JQIamo/Linear-Temperature-Controller/v1_0 (first prod run)/LinTempCont_v1_0_BOM.xlsx

 |  |  |  |  |  |  |  |  |  |  |  |  | Needed | Packed | Extra
Item # | Qty | Value | Ref Des | Device | Package | Description | DIGIKEY | MFR_PN | Type | SMT | Thru Hole | Comments
1 | 4 |  | D1, D2, D3, D4 | LED/MINI-IND | HLMP--F0010 | Through-hole, side-view LED | 516-1417-ND |  | thru-hole |  | 4 | y | 44 | 46 | 2
2 | 9 |  | JP3, JP5, JP6, JP7, JP9, JP10, JP12, JP13, JP14 | PINHD-1X2 | 1X02 | PIN HEADER | 952-2262-ND |  | thru-hole |  | 9 | y | 99 | 100 | 1
3 | 1 |  | LCD_HEADER | PINHD-2X4-SHROUD | ML08 | PIN HEADER | 609-3530-ND |  | thru-hole |  | 1 | y | 11 | 11 | 0 | have lots more
4 | 4 |  | JP1, JP2, JP8, JP11 | PINHD-2X6/90 | 2X06/90 | PIN HEADER | 609-3345-ND |  | thru-hole |  | 4 | y | 44 | 46 | 2
5 | 1 |  | JP4 | SCRWTRM-1X2 | 1X02_SCRWTRM | Screw Terminal | ED2635-ND | OSTTE020161 | thru-hole |  | 1 | y | 11 | 12 | 1
6 | 4 |  | S1, S2, S3, S4 | SWITCH-DPDT/VER | E-SWITCH-100-M7 | DPDT Switch | 100DP1T2B4M7QE-ND | 100DP1T2B4M7QE | thru-hole |  | 4 | y | 44 | 46 | 2
7 | 1 |  | IC6 | TS6001 | SOT-23 | 2.5V Reference IC | TS6001BIG325TCT-ND |  | smt | 1 |  | x | 11 | 11 | 0
8 | 15 | 0.1uF | C1, C3, C4, C5, C6, C7, C8, C9, C11, C12, C15, C20, C22, C24, C27 | CAP0603 | 0603 | SMT Capacitor | 399-5089-1-ND |  | smt | 15 |  | x | 165 | 185 | 20
9 | 12 | 1.0k | R14, R15, R18, R52, R53, R54, R70, R71, R72, R88, R89, R90 | RES0603 | 0603 | SMT Resistor | MCT0603-1.00K-CFCT-ND |  | smt | 12 |  | x | 132 | 138 | 6
10 | 8 | 1.5k | R2, R4, R38, R40, R56, R58, R74, R76 | RES0603 | 0603 | SMT Resistor | MCT0603-1.50K-CFCT-ND |  | smt | 8 |  | x | 88 | 92 | 4
11 | 2 | 1000pF | C10, C14 | CAP0603 | 0603 | SMT Capacitor | 399-3293-1-ND |  | smt | 2 |  | x | 22 | 49 | 27
12 | 8 | 10k | R6, R7, R41, R42, R59, R60, R77, R78 | MODEL64_TRIMPOT/TOP-ADJ | 64WPOT | Trimpot | 987-1061-ND |  | thru-hole |  | 8 | y | 88 | 92 | 4
13 | 34 | 10k | R8, R9, R10, R12, R13, R19, R20, R21, R22, R23, R24, R25, R26, R27, R28, R29, R32, R33, R34, R43, R44, R45, R47, R48, R61, R62, R63, R65, R66, R79, R80, R81, R83, R84 | RES0603 | 0603 | SMT Resistor | MCT0603-10.0K-CFCT-ND |  | smt | 34 |  | x | 374 | 466 | 92
14 | 4 | 10nF | C16, C17, C18, C19 | C-EUC0603 | C0603 | SMT Capacitor | 399-1091-1-ND |  | smt | 4 |  | x | 44 | 50 | 6
15 | 7 | 10uF | CP2, C2, C13, C21, C23, C25, C30 | CAP0805 | 0805 | SMT Capacitor | 1276-2891-1-ND |  | smt | 7 |  | x | 77 | 100 | 23
16 | 1 | 220uF | CP1 | CPOL-USF | PANASONIC_F | SMT Polarized Capacitor | PCE3955CT-ND |  | smt | 1 |  | x | 11 | 12 | 1
17 | 4 | 330 | R5, R49, R67, R85 | RES0603 | 0603 | SMT Resistor | MCT0603-330-CFCT-ND |  | smt | 4 |  | x | 44 | 46 | 2
18 | 4 | 33k | R11, R46, R64, R82 | RES0603 | 0603 | SMT Resistor | MCT0603-33.0K-CFCT-ND |  | smt | 4 |  | x | 44 | 46 | 2
19 | 8 | 4.3k | R1, R3, R37, R39, R55, R57, R73, R75 | RES0603 | 0603 | SMT Resistor | 541-4.3KGCT-ND |  | smt | 8 |  | x | 88 | 92 | 4
20 | 1 | 47uF | CP3 | CPOL-USCT7343 | CT7343 | SMT Polarized Capacitor | 495-1571-1-ND |  | smt | 1 |  | x | 11 | 12 | 1
21 | 4 | 50 | R30, R31, R35, R36 | RES0603 | 0603 | SMT Resistor | 541-51GCT-ND |  | smt | 4 |  | x | 44 | 46 | 2
22 | 4 | AD5262 | IC4, IC5, IC8, IC10 | AD5262 | TSSOP16 | AD5262 dual circuit digital pot | AD5262BRUZ200-ND |  | smt | 4 |  | x | 44 | 45 | 1
23 | 1 | AD5624R | IC3 | AD5624R | MSOP10 | AD5624R Quad Output DAC w/internal Vref | AD5624RBRMZ-3-ND |  | smt | 1 |  | x | 11 | 12 | 1
24 | 8 | BNC-H | X1, X2, X3, X4, X5, X6, X7, X8 | BNC-H | BNC90 | BNC Connector. | A32260-ND |  | thru-hole |  | 8 |  | 88 | 28 | -60
25 | 4 | Ferrite 1k | L1, L2, L3, L4 | INDUCTOR-0805 | 0805 | SMT Inductor. | 445-5223-1-ND |  | smt | 4 |  | x | 44 | 49 | 5
26 | 4 | LM393D | IC1, IC2, IC7, IC9 | LM393D | SO08 | COMPARATOR | 296-1015-5-ND |  | smt | 4 |  | x | 44 | 47 | 3
27 | 8 | MMBT3904 | T1, T2, T3, T4, T5, T6, T7, T8 | MMBT3904 | SOT-23 | NPN TRANSISTOR | MMBT3904-FDICT-ND |  | smt | 8 |  | x | 88 | 94 | 6
28 | 2 | PEC09 | ENC1, ENC2 | PEC09 | PEC092320FS | PEC09-2320F-S0015 Rotary Encoder (Bourns). | PEC09-2320F-S0015-ND |  | thru-hole |  | 2 | y | 22 | 25 | 3
29 | 1 | TEENSY_3.1+4 | U$1 | TEENSY_3.1+4 | TEENSY_3.1+4 | Footprint for Teensy 3.1 board using all through-holes |  |  | DNP |  |  | **DO NOT PLACE | 11
30 | 27 | TESTPT | TP1, TP2, TP3, TP4, TP5, TP6, TP7, TP8, TP9, TP10, TP11, TP12, TP13, TP14, TP15, TP16, TP17, TP18, TP19, TP20, TP21, TP22, TP23, TP24, TP25, TP26, TP27 | TESTPT | 1206TESTPAD |  | A106143CT-ND |  | smt | 27 |  | x | 297 | 303 | 6
 |  |  |  |  |  |  |  |  |  | 153 | 41
