JQIamo/Linear-Temperature-Controller/v1_0 (first prod run)/Digikey Order.xlsx

web id: | 148701440 |  |  |  |  |  |  | **means a part is for the individual channel temp controller circuit
access id: | 38776
item number | part number | description | customer reference | qty | unit price | ext price
1 | 609-3345-ND | CONN HEADER 12POS .100 R/A 15AU | JP1, JP2, JP8, JP11 | 50 | 0.8056 | $40.28
2 | MMBT3904-FDICT-ND | TRANS NPN 40V 0.2A SMD SOT23-3 | T1, T2, T3, T4, T5, T6, T7, T8 | 100 | 0.0742 | $7.42
3 | 296-1015-5-ND | IC DUAL DIFF COMP 8-SOIC | IC1, IC2, IC7, IC9 | 50 | 0.3 | $15.00
4 | AD5262BRUZ200-ND | IC POT DUAL 200K 256POS 16TSSOP | IC4, IC5, IC8, IC10 | 48 | 4.679 | $224.59
5 | AD5624RBRMZ-3-ND | IC DAC NANO 12BIT 1.25V 10-MSOP | IC3 | 12 | 9.79 | $117.48
6 | A32260-ND | CONN BNC JACK R/A 50 OHM PCB | X1-X8 | 45 | 2.74 | $123.30
7 | TS6001BIG325TCT-ND | IC VREF SERIES 2.5V SOT23-3 | IC6 | 12 | 0.871 | $10.45
8 | 445-5223-1-ND | FERRITE CHIP 1000 OHM 1.5A 0805 | L1, L2, L3, L4 | 100 | 0.0574 | $5.74
9 | A106143CT-ND | 1206 PROBE PAD | TP1-27 | 330 | 0.152 | $50.16
10 | PCE3955CT-ND | CAP ALUM 220UF 20% 35V SMD | CP1 | 75 | 0.4872 | $36.54
11 | 516-1417-ND | LED DOME 565NM GRN DIFF RA AXIAL | D1-D4 | 50 | 0.4436 | $22.18
12 | 987-1061-ND | TRIMMER 10K OHM 0.25W TH | R6, R7, R41, R42, R59, R60, R77, R78 | 100 | 1.176 | $117.60
13 | PEC09-2320F-S0015-ND | ENCODER INCREMENTAL 9MM W/SWITCH | ENC1, ENC2 | 25 | 2.8692 | $71.73
14 | 450-1693-ND | SWITCH KNOB DIAMOND .50" BLACK |  | 25 | 4.57 | $114.25
15 | ED2635-ND | TERM BLOCK 3.5MM VERT 2POS PCB | JP4 | 12 | 0.402 | $4.82
16 | 100DP1T2B4M7QE-ND | SWITCH TOGGLE DPDT 5A 120V | S1-S4 | 50 | 3.3768 | $168.84
17 | 609-3530-ND | CONN HEADER 8POS DUAL VERT PCB |  | 50 | 0.5972 | $29.86
18 | 399-1091-1-ND | CAP CER 10000PF 50V 10% X7R 0603 | C1, C16, C17, C18, C19 | 250 | 0.00736 | $1.84
19 | 1276-2891-1-ND | CAP CER 10UF 25V 10% X5R 0805 | CP2, C2, C13, C21, C23, C25, C30 | 250 | 0.1024 | $25.60
20 | 399-3293-1-ND | CAP CER 1000PF 50V 5% NP0 0603 | C14 | 50 | 0.0318 | $1.59
21 | 399-5089-1-ND | CAP CER 0.1UF 50V 10% X7R 0603 | C3-C12, C15, C20, C22, C24, C27 | 250 | 0.01532 | $3.83
22 | 952-2262-ND | SIL VERTICAL PC TAIL PIN HEADER | JP3, JP5-JP7, JP9, JP10, JP12-JP14 | 100 | 0.0609 | $6.09
23 | MCT0603-10.0K-CFCT-ND | RES SMD 10K OHM 1% 1/8W 0603 | RR1 - RR34 | 500 | 0.033 | $16.50
24 | MCT0603-1.00K-CFCT-ND | RES SMD 1K OHM 1% 1/8W 0603 | R14, R15, R18, R52-R54, R70-R72, R88-R90 | 150 | 0.0408 | $6.12
25 | MCT0603-1.50K-CFCT-ND | RES SMD 1.5K OHM 1% 1/8W 0603 | R2, R4, R38, R40, R56, R58, R74, R76 | 100 | 0.0408 | $4.08
26 | MCT0603-330-CFCT-ND | RES SMD 330 OHM 1% 1/8W 0603 | R5, R49, R67, R85 | 50 | 0.0516 | $2.58
27 | MCT0603-33.0K-CFCT-ND | RES SMD 33K OHM 1% 1/8W 0603 | R11, R46, R64, R82 | 50 | 0.0516 | $2.58
28 | 541-4.3KGCT-ND | RES SMD 4.3K OHM 5% 1/10W 0603 | R1, R3, R37, R39, R55, R57, R73, R75 | 100 | 0.04 | $4.00
29 | 541-51GCT-ND | RES SMD 51 OHM 5% 1/10W 0603 | R30, R31, R35, R36 | 50 | 0.04 | $2.00
30 | S7109-ND | CONN HEADER FMAL 12PS.1" DL GOLD | **JP3 | 50 | 0.7042 | $35.21
31 | OP727ARUZ-ND | IC OPAMP GP 700KHZ RRO 8TSSOP | **IC1 | 50 | 4.133 | $206.65
32 | 296-18688-1-ND | IC OPAMP DIFF 1.5MHZ 8VSSOP | **IC2 | 50 | 3.58 | $179.00
33 | ED1501-ND | TERMINAL BLOCK 3.5MM 2POS PCB | **JP2 | 50 | 0.5064 | $25.32
34 | ED1503-ND | TERMINAL BLOCK 3.5MM 4POS PCB | **JP1 | 50 | 0.9706 | $48.53
35 | 541-0.0GCT-ND | RES SMD 0.0 OHM JUMPER 1/10W | **R1, R2 | 100 | 0.04 | $4.00
36 | MCT0603-100K-CFCT-ND | RES SMD 100K OHM 1% 1/8W 0603 | **R4, R5 | 100 | 0.0408 | $4.08
37 | 1276-2876-1-ND | CAP CER 10UF 50V 10% X5R 1206 | **CP2 | 50 | 0.4424 | $22.12
38 | A119984CT-ND | RES SMD 20K OHM 0.1% 1/10W 0805 | **R6 | 50 | 0.33 | $16.50
39 | 495-1571-1-ND | CAP TANT 47UF 25V 10% 2917 | CP3 | 75 | 1.264 | $94.80
40 | 311-1900-1-ND | CAP CER 22UF 10V 20% X5R 0805 | **C1 | 50 | 0.1612 | $8.06
41 | MCT0603-3.30K-CFCT-ND | RES SMD 3.3K OHM 1% 1/8W 0603 | **R3 | 50 | 0.0516 | $2.58
42 | 587-1757-1-ND | FERRITE BEAD 1000 OHM 1810 | **LP2 | 50 | 0.3342 | $16.71
43 | CDPM1000-ND | AC/DC CONVERTER 5V 1W |  | 10 | 19.855 | $198.55
44 | A208-ND | CONN SOCKET SIP 25POS GOLD |  | 40 | 3.2176 | $128.70
45 | 931-1188-ND | HIROSE U.FL TO SMA(F) 200MM |  | 15 | 6.49 | $97.35 | for long steck lasers
46 | 102-2527-ND | AC/DC CONVERTER 5V 12V 30W |  | 3 | 28.48 | $85.44
47 | 454-1423-ND | AC/DC CONVERTER 24V 60W |  | 1 | 24.41 | $24.41
48 | 454-1597-ND | KIT CONNECTOR MATING LPX25/40/60 |  | 1 | 9.68 | $9.68
49 | 259-1551-ND | FAN AXIAL 30X10MM VAPO 5VDC WIRE |  | 10 | 6.088 | $60.88
50 | 259-1549-ND | FAN AXIAL 30X10MM 12VDC WIRE |  | 10 | 6.799 | $67.99
51 | MD08R-100-ND | CBL RIBN 8COND 0.050 GRAY 100' |  | 1 | 42.35 | $42.35 | for lcd breakout boards
52 | 609-3568-ND | CONN SOCKET IDC 8POS DL SR 30AU |  | 100 | 0.7106 | $71.06 | for lcd breakout boards
53 | WM17458-ND | CONN HEADER 8POS .100" VERT 15AU |  | 50 | 0.5882 | $29.41 | for lcd breakout boards
54 | NHD-C0216CZ-FSW-FBW-3V3-ND | LCD COG CHAR 2X16 WHT TRANSFL |  | 10 | 9.68 | $96.80 | for lcd breakout boards
55 | AD8038AKSZ-REEL7CT-ND | IC OPAMP VFB 350MHZ SC70-5 | AOM_OP_AMP | 10 | 2.052 | $20.52 | for aom board
56 | LMH6629MFE/NOPBCT-ND | IC OPAMP VFB 1GHZ SOT23-5 | PD_AMP | 5 | 5.16 | $25.80 | for photodiode amplifier board
57 | 296-15172-1-ND | IC OPAMP VFB 3.9GHZ SOT23-6 | PD_AMP_2 | 2 | 6.54 | $13.08 | for photodiode amplifier board
 |  |  |  |  |  | $2872.63
