JQIamo/Linear-Temperature-Controller/v1_0 (first prod run)/indCh_v0_9/LinTempCont_indCH_v1_0_BOM.xlsx

Sheet: Sheet1
Item # | Qty | Ref Des | Value | Device | Package | Description | DIGIKEY PN | Type | Comments
1 | 1 | IC2 |  | INA159 | VSSOP8 | INA159 Difference Amplifier, Texas Instruments | 296-18688-1-ND | smt
2 | 1 | IC1 |  | OP727 | TSSOP8 | OP727 Dual Op Amp | OP727ARUZ-ND | smt
3 | 1 | JP3 |  | PINHD-2X6 | 2X06 | PIN HEADER |  | DNP | **DO NOT PLACE
4 | 1 | JP2 |  | SCRWTRM-1X2/90_ED550 | 1X02_RA_SCRWTRM_ED550 | Screw Terminal | ED1501-ND | DNP | **DO NOT PLACE
5 | 1 | JP1 |  | SCRWTRM-1X4/90_ED550 | 1X04_RA_SCRWTRM_ED550 | Screw Terminal | ED1503-ND | thru-hole
6 | 1 | U1 |  | WTC3243 | WTC3293 | WTC3243 linear temp controller chip from Team Wavelength |  | DNP | **DO NOT PLACE
7 | 2 | R1, R2 | 0 | RES0603 | 0603 | SMT Resistor | 541-0.0GCT-ND | smt
8 | 1 | C8 | 0.1uF | CAP0603 | 0603 | SMT Capacitor | 399-5089-1-ND | smt
9 | 2 | R4, R5 | 100k 1% | RES0603 | 0603 | SMT Resistor | MCT0603-100K-CFCT-ND | smt
10 | 3 | C2, C5, C6 | 10nF | CAP0603 | 0603 | SMT Capacitor | 399-1091-1-ND | smt
11 | 3 | C3, C4, C7 | 10uF | CAP0805 | 0805 | SMT Capacitor | 1276-2891-1-ND | smt
12 | 1 | CP2 | 10uF 50V | C-USC1206 | C1206 | SMT Capacitor | 1276-2876-1-ND | smt
13 | 1 | R6 | 20k 0.1% | R_SMDR0805 | R_0805 | SMT Resistor | A119984CT-ND | smt
14 | 1 | CP1 | 220uF | CPOL-USF | PANASONIC_F | SMT Polarized Capacitor | PCE3955CT-ND | smt
15 | 1 | C1 | 22uF | CAP0805 | 0805 | SMT Capacitor | 311-1900-1-ND | smt
16 | 1 | R3 | 3.3k | RES0603 | 0603 | SMT Resistor | MCT0603-3.30K-CFCT-ND | smt
17 | 1 | CP3 | 47uF | CPOL-USCT7343 | CT7343 | SMT Polarized Capacitor | 495-1571-1-ND | smt
18 | 1 | LP2 | Ferrite 1k | L_FERRITE_SMD | L_FERRITE_1810 | SMT Inductor | 587-1757-1-ND | smt
19 | 3 | RI, RP, RSG |  | RES0603 | 0603 | SMT Resistor |  | DNP | **DO NOT PLACE
20 | 1 | L1 | Ferrite 1k | INDUCTOR-0805 | 0805 | SMT Inductor | 445-5223-1-ND | smt

Sheet: Sheet2
Qty | Device | Package | Description | DIGIKEY | MFR_PN
1 | INA159 | VSSOP8 | INA159 Difference Amplifier, Texas Instruments | 296-18688-1-ND
1 | OP727 | TSSOP8 | OP727 Dual Op Amp | OP727ARUZ-ND
1 | PINHD-2X6 | 2X06 | PIN HEADER
1 | SCRWTRM-1X2/90_ED550 | 1X02_RA_SCRWTRM_ED550 | Screw Terminal | ED1501-ND | ED550/2DS
1 | SCRWTRM-1X4/90_ED550 | 1X04_RA_SCRWTRM_ED550 | Screw Terminal | ED1503-ND | ED550/4DS
1 | WTC3243 | WTC3293 | WTC3243 linear temp controller chip from Team Wavelength
2 | RES0603 | 603 | SMT Resistor
1 | CAP0603 | 603 | SMT Capacitor
2 | RES0603 | 603 | SMT Resistor
1 | C-USC0603 | C0603 | CAPACITOR, American symbol
2 | CAP0603 | 603 | SMT Capacitor
1 | C-USC0805 | C0805 | CAPACITOR, American symbol
2 | CAP0805 | 805 | SMT Capacitor
1 | C-USC1206 | C1206 | CAPACITOR, American symbol
1 | R_SMDR0805 | R_0805
1 | CPOL-USF | PANASONIC_F | POLARIZED CAPACITOR, American symbol
1 | CAP0805 | 805 | SMT Capacitor
1 | RES0603 | 603 | SMT Resistor
1 | CPOL-USCT7343 | CT7343 | POLARIZED CAPACITOR, American symbol
1 | L_FERRITE_SMD | L_FERRITE_1810
3 | RES0603 | 603 | SMT Resistor
1 | INDUCTOR-0805 | 805 | SMT Inductor.
