JQIamo/Linear-Temperature-Controller/v1_0 (first prod run)/indCh_v0_9/indCh_v0_9.brd

## EAGLE design v1_0 (first prod run)/indCh_v0_9/indCh_v0_9.brd (2015-08-05)

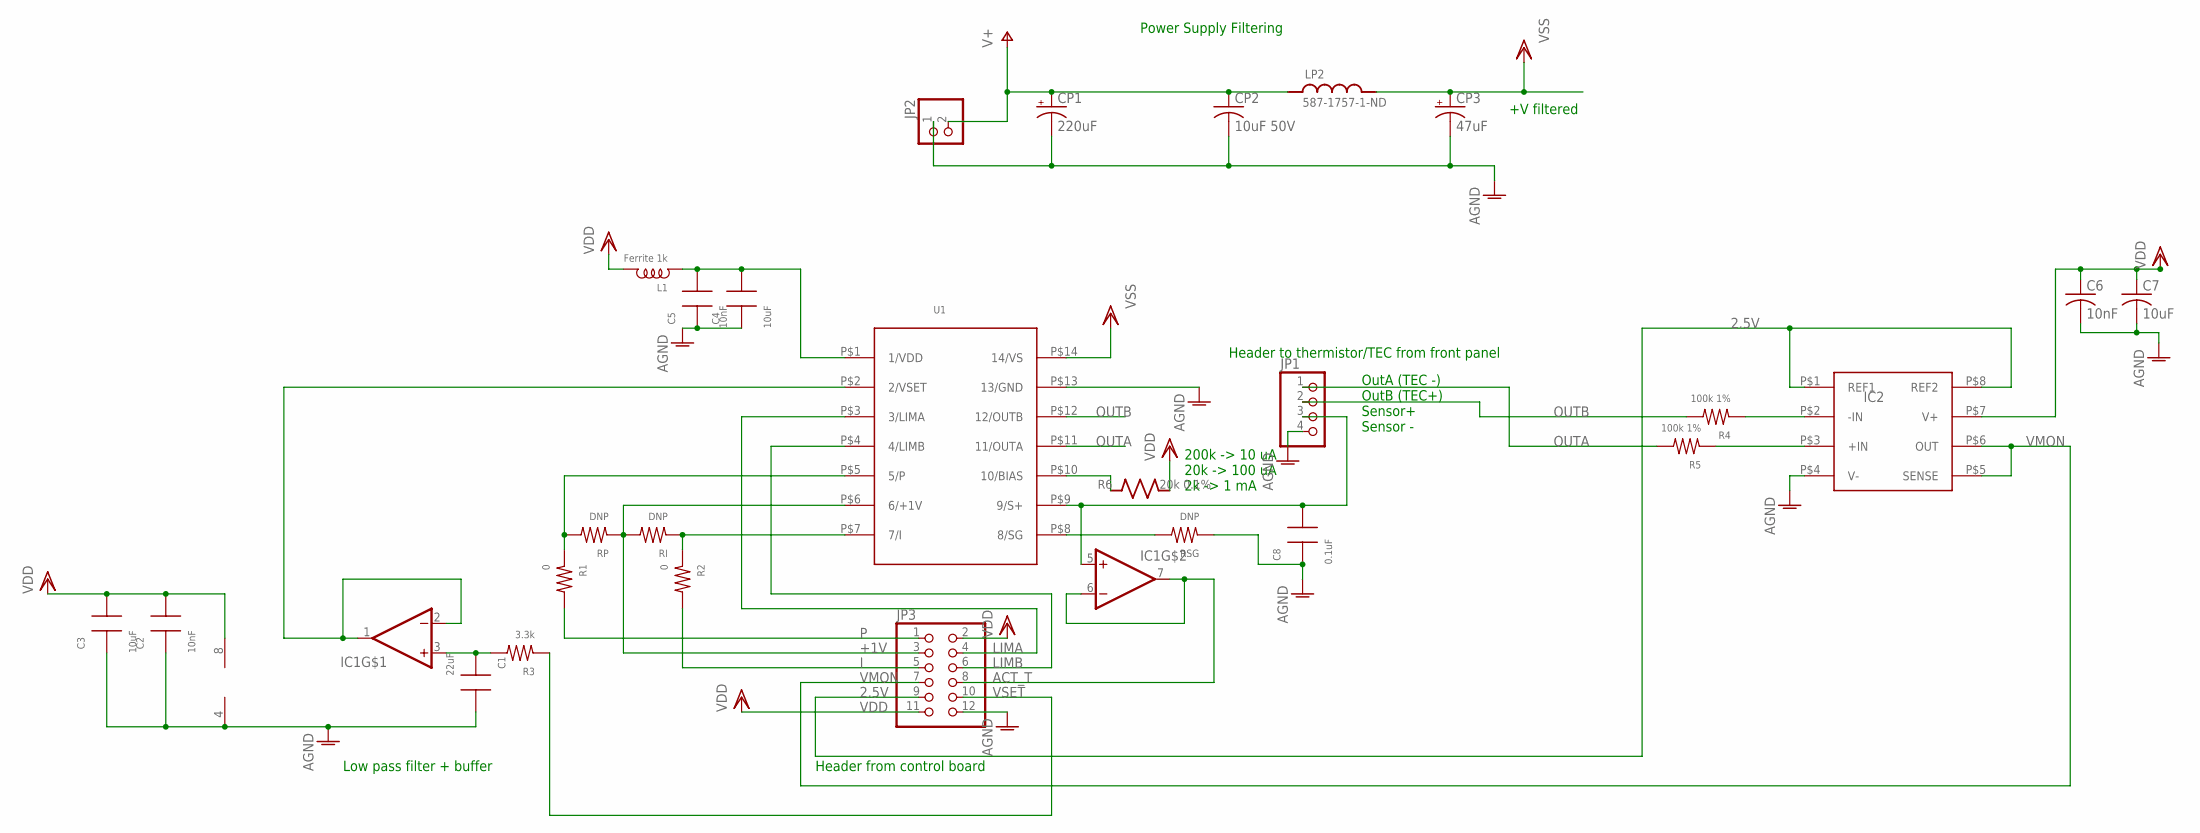
[picture p1: schematic indCh_v0_9.sch]

Parts:
C1: 22uF; 0805
C2, C5: 10nF; 0603
C3, C4: 10uF; 0805
C6: 10nF; C0603
C7: 10uF; C0805
C8: 0.1uF; 0603
CP1: 220uF; PANASONIC_F
CP2: 10uF 50V; C1206
CP3: 47uF; CT7343
IC1: OP727; TSSOP8
IC2: INA159; VSSOP8
JP1: SCRWTRM-1X4/90_ED550; 1X04_RA_SCRWTRM_ED550
JP2: SCRWTRM-1X2/90_ED550; 1X02_RA_SCRWTRM_ED550
JP3: PINHD-2X6; 2X06
L1: Ferrite 1k; 0805
LP2: 587-1757-1-ND; L_FERRITE_1810
R1, R2: 0; 0603
R3: 3.3k; 0603
R4, R5: 100k 1%; 0603
R6: 20k 0.1%; R_0805
RI: DNP; 0603
RP: DNP; 0603
RSG: DNP; 0603
U1: WTC3243; WTC3293

Connections:
2.5V: IC2.P$1 (REF1), IC2.P$8 (REF2), JP3.9
+1V: JP3.3, RI.2, RP.1, U1.P$6 (6/+1V)
ACT_T: IC1.6 (-IN), IC1.7 (OUT), JP3.8
AGND: C1.2, C2.1, C3.1, C4.1, C5.1, C6.2, C7.2, C8.1, CP1.-, CP2.2, CP3.-, IC1.4 (V-), IC2.P$4 (V-), JP1.4, JP2.1, JP3.12, RSG.1, U1.P$13 (13/GND)
I: JP3.5, R2.2
LIMA: JP3.4, U1.P$3 (3/LIMA)
LIMB: JP3.6, U1.P$4 (4/LIMB)
unnamed: R1.1, RP.2, U1.P$5 (5/P)
unnamed: C8.2, IC1.5 (+IN), JP1.3, U1.P$9 (9/S+)
unnamed: R2.1, RI.1, U1.P$7 (7/I)
unnamed: R6.P$1 (1), U1.P$10 (10/BIAS)
unnamed: C1.1, IC1.3 (+IN), R3.2
unnamed: RSG.2, U1.P$8 (8/SG)
unnamed: IC1.1 (OUT), IC1.2 (-IN), U1.P$2 (2/VSET)
unnamed: IC2.P$2 (-IN), R4.1
unnamed: IC2.P$3 (+IN), R5.1
unnamed: C4.2, C5.2, L1.1, U1.P$1 (1/VDD)
OUTA: JP1.1, R5.2, U1.P$11 (11/OUTA)
OUTB: JP1.2, R4.2, U1.P$12 (12/OUTB)
P: JP3.1, R1.2
V+: CP1.+, CP2.1, JP2.2, LP2.P$1 (1)
VDD: C2.2, C3.2, C6.1, C7.1, IC1.8 (V+), IC2.P$7 (V+), JP3.2, JP3.11, L1.2, R6.P$2 (2)
VMON: IC2.P$5 (SENSE), IC2.P$6 (OUT), JP3.7
VSET: JP3.10, R3.1
VSS: CP3.+, LP2.P$2 (2), U1.P$14 (14/VS)

Notes on the sheet:
Header from control board
Power Supply Filtering
Header to thermistor/TEC from front panel
+V filtered
200k -> 10 uA 20k -> 100 uA 2k -> 1 mA
Low pass filter + buffer
OutA (TEC -) OutB (TEC+) Sensor+ Sensor -

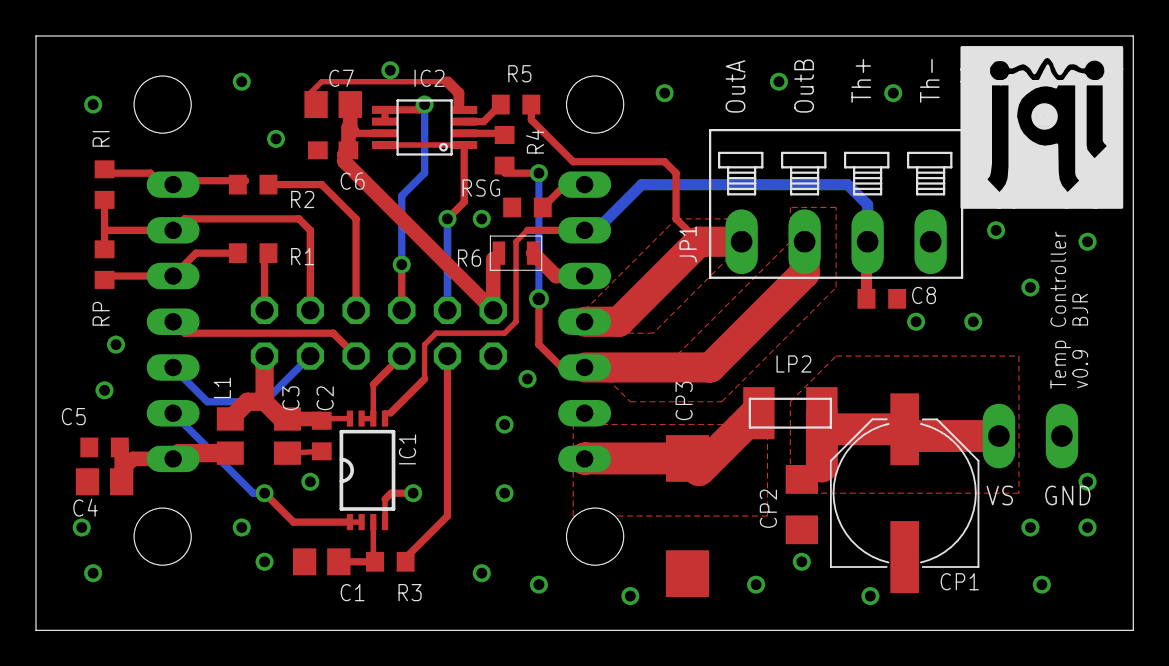
[picture p2: board indCh_v0_9.brd from above]

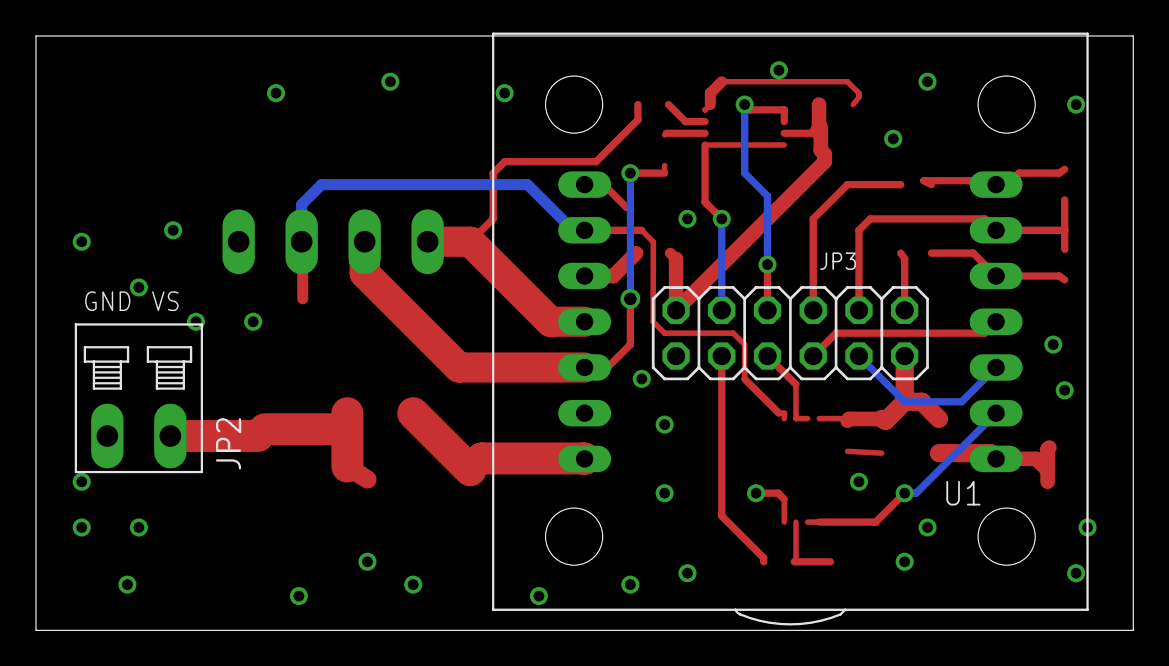
[picture p3: board indCh_v0_9.brd from below]

Board: 2 copper layers, 61.0 x 33.0 mm, 29 parts (3 on the bottom side), 25 nets.

Other parts of the board:
U$1: JQI_LOGO_NEGATIVE-SILKSCREEN
