JQIamo/Linear-Temperature-Controller/v0_1/Linear-Temperature-Controller.brd

## EAGLE design v0_1/Linear-Temperature-Controller.brd (2015-06-29)

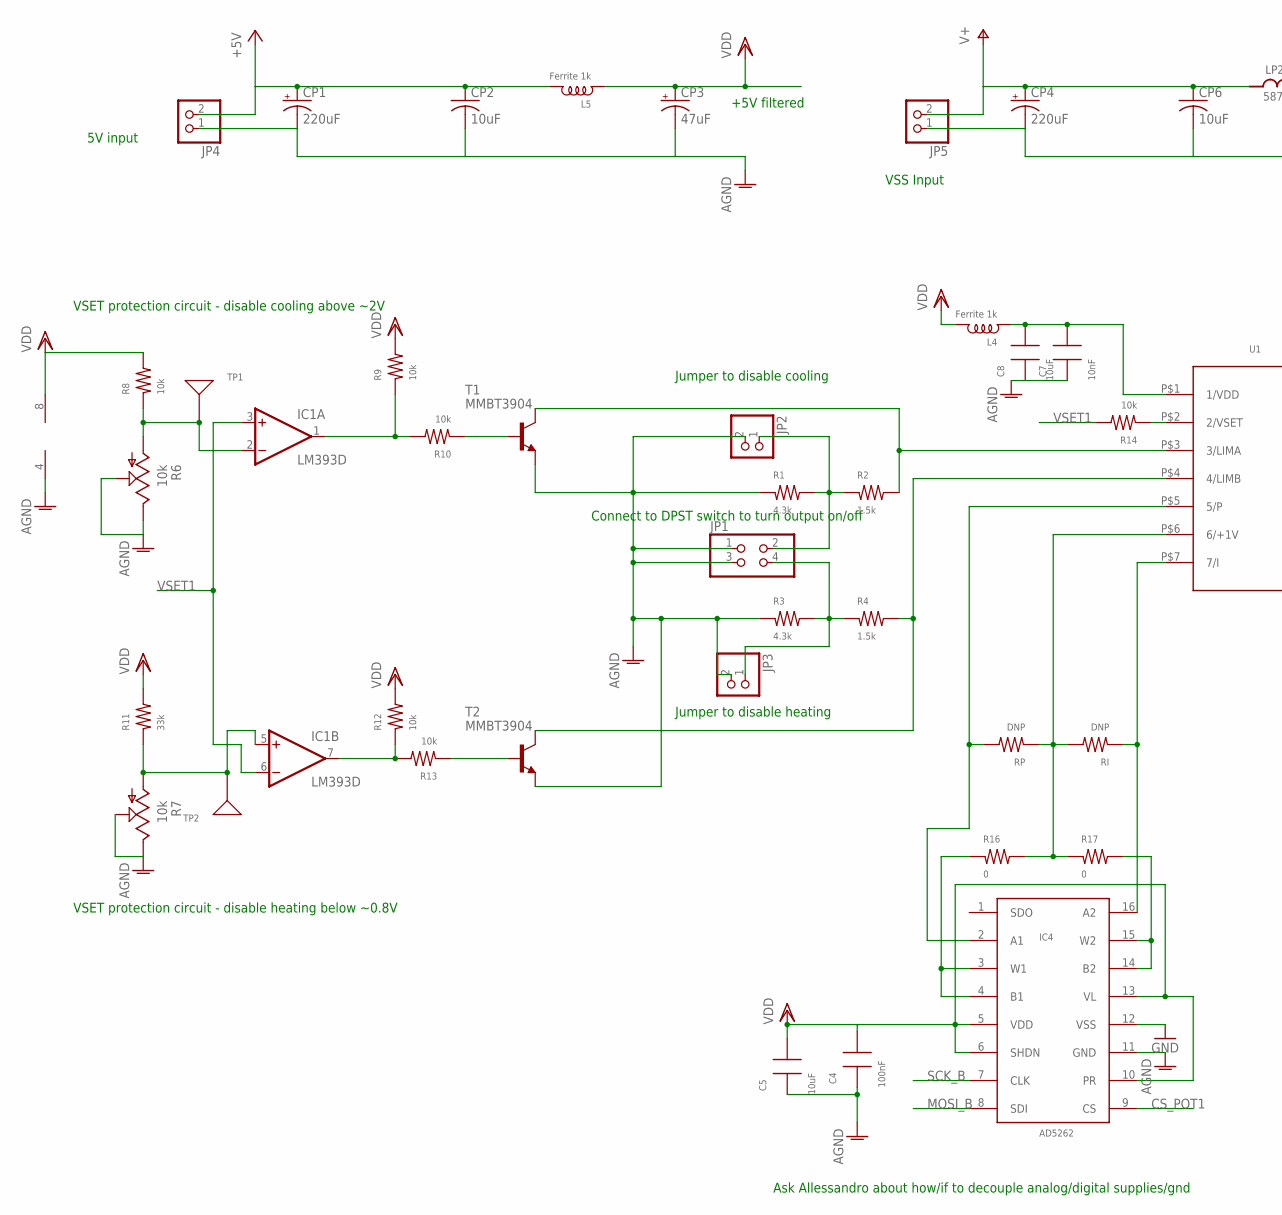
[picture p4: schematic Linear-Temperature-Controller.sch, sheet 1, part in row 1, column 1]

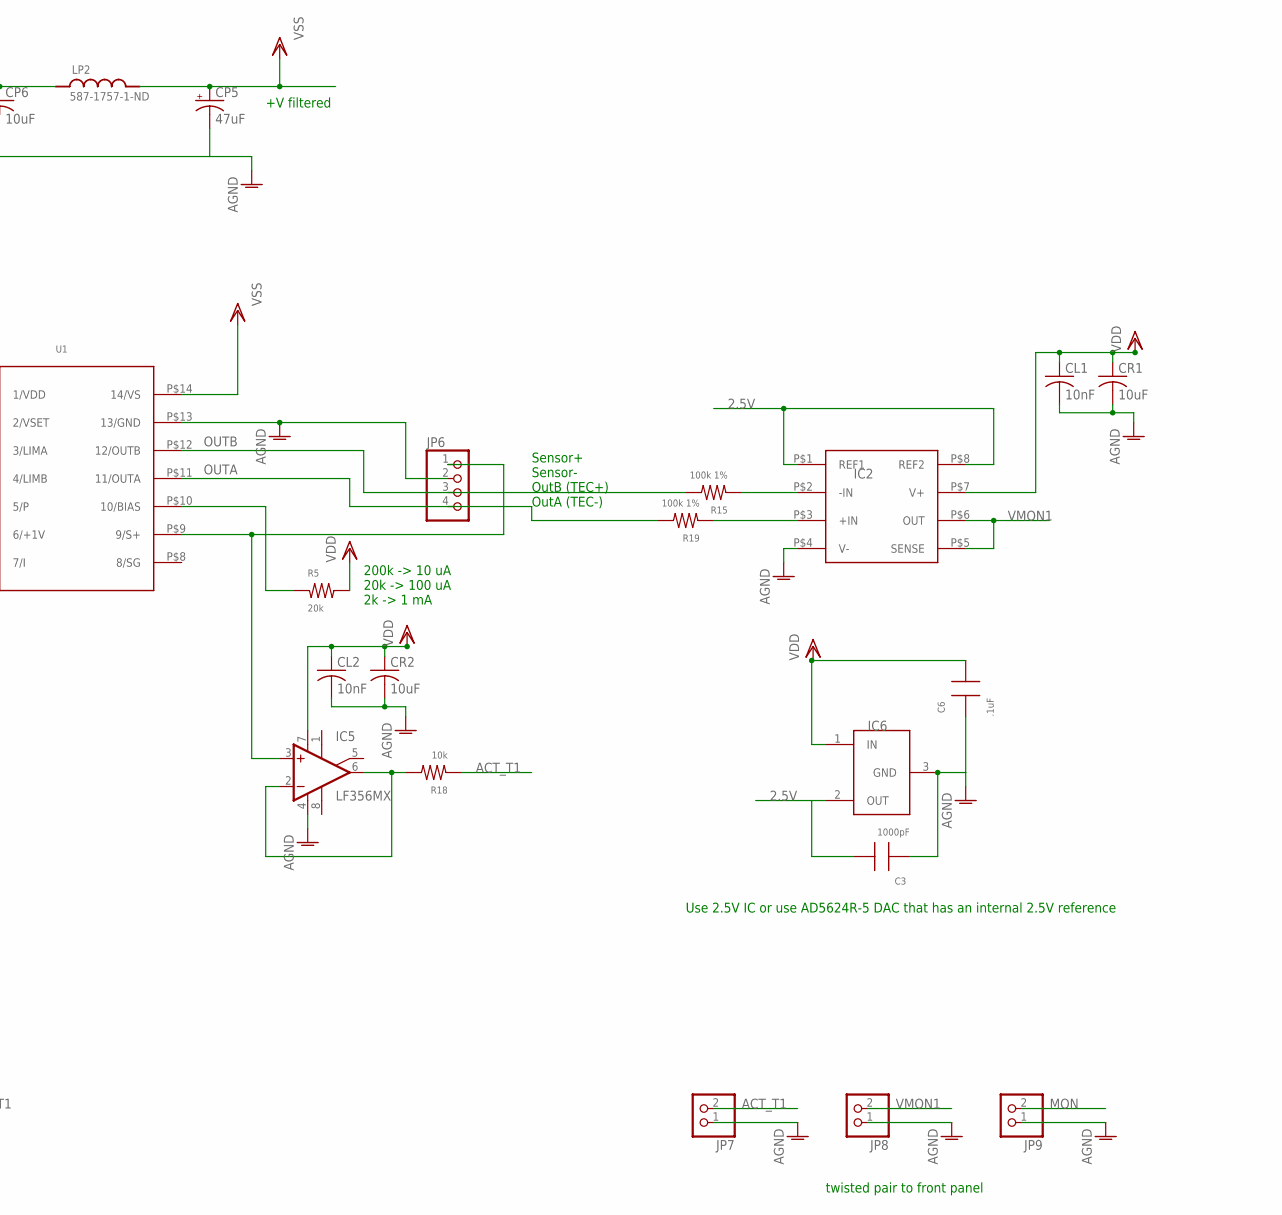
[picture p5: schematic Linear-Temperature-Controller.sch, sheet 1, part in row 1, column 2]

Parts:
C3: 1000pF; 0805
C4: 100nF; 0805
C5, C8: 10uF; 0805
C6: .1uF; 0805
C7: 10nF; 0805
CL1, CL2: 10nF; C0805
CP1, CP4: 220uF; PANASONIC_F
CP2, CP6: 10uF; C0805K
CP3, CP5: 47uF; CT7343
CR1, CR2: 10uF; C0805
IC1: LM393D; SO08
IC2: INA159; VSSOP8
IC4: AD5262; TSSOP16
IC5: LF356MX; SO08
IC6: TS6001; SOT-23
JP1: PINHD-2X2; 2X02
JP2, JP3, JP4, JP5, JP7, JP8, JP9: PINHD-1X2; 1X02
JP6: PINHD-1X4; 1X04
L4, L5: Ferrite 1k; 0805
LP2: 587-1757-1-ND; L_FERRITE_1810
R1, R3: 4.3k; 0805
R2, R4: 1.5k; 0805
R5: 20k; 0805
R6, R7: 10k; 64XPOT
R8, R9, R10, R12, R13, R14, R18: 10k; 0805
R11: 33k; 0805
R15, R19: 100k 1%; 1206
R16, R17: 0; 0805
RI: DNP; 0805
RP: DNP; 0805
T1, T2: MMBT3904; SOT-23
TP1, TP2: TESTPT; 1206TESTPAD
U1: WTC3243; WTC3293

Connections:
2.5V: C3.2, IC2.P$1 (REF1), IC2.P$8 (REF2), IC6.2 (OUT); also elsewhere on the board
+5V: CP1.+, CP2.1, JP4.2, L5.2
ACT_T1: JP7.2, R18.1; also elsewhere on the board
AGND: C3.1, C4.1, C5.1, C6.1, C7.1, C8.1, CL1.2, CL2.2, CP1.-, CP2.2, CP3.-, CP4.-, CP5.-, CP6.2, CR1.2, CR2.2, IC1.4 (V-), IC2.P$4 (V-), IC4.11 (GND), IC5.4 (V-), IC6.3 (GND), JP1.1, JP1.3, JP2.2, JP3.2, JP4.1, JP5.1, JP6.2, JP7.1, JP8.1, JP9.1, R1.1, R3.1, R6.P$2 (2), R6.P$3 (3), R7.P$2 (2), R7.P$3 (3), T1.2 (E), T2.2 (E), U1.P$13 (13/GND); also elsewhere on the board
CS_POT1: IC4.9 (CS); also elsewhere on the board
DGND: IC4.12 (VSS); also elsewhere on the board
MON: JP9.2; also elsewhere on the board
MOSI_B: IC4.8 (SDI); also elsewhere on the board
unnamed: R2.2, T1.3 (C), U1.P$3 (3/LIMA)
unnamed: JP1.2, JP2.1, R1.2, R2.1
unnamed: R4.2, T2.3 (C), U1.P$4 (4/LIMB)
unnamed: JP1.4, JP3.1, R3.2, R4.1
unnamed: R5.1, U1.P$10 (10/BIAS)
unnamed: IC1.2 (-IN), R6.P$1 (1), R8.1, TP1.P$1
unnamed: IC1.5 (+IN), R7.P$1 (1), R11.1, TP2.P$1
unnamed: IC1.7 (OUT), R12.1, R13.2
unnamed: IC1.1 (OUT), R9.1, R10.2
unnamed: R10.1, T1.1 (B)
unnamed: R13.1, T2.1 (B)
unnamed: R14.1, U1.P$2 (2/VSET)
unnamed: IC5.3 (+IN), JP6.1, U1.P$9 (9/S+)
unnamed: IC2.P$2 (-IN), R15.1
unnamed: IC4.2 (A1), RP.2, U1.P$5 (5/P)
unnamed: IC2.P$3 (+IN), R19.1
unnamed: R16.2, R17.1, RI.2, RP.1, U1.P$6 (6/+1V)
unnamed: IC4.3 (W1), IC4.4 (B1), R16.1
unnamed: IC4.16 (A2), RI.1, U1.P$7 (7/I)
unnamed: IC4.14 (B2), IC4.15 (W2), R17.2
unnamed: IC5.2 (-IN), IC5.6 (OUT), R18.2
unnamed: C7.2, C8.2, L4.1, U1.P$1 (1/VDD)
OUTA: JP6.4, R19.2, U1.P$11 (11/OUTA)
OUTB: JP6.3, R15.2, U1.P$12 (12/OUTB)
SCK_B: IC4.7 (CLK); also elsewhere on the board
V+: CP4.+, CP6.1, JP5.2, LP2.P$1 (1)
VDD: C4.2, C5.2, C6.2, CL1.1, CL2.1, CP3.+, CR1.1, CR2.1, IC1.8 (V+), IC2.P$7 (V+), IC4.5 (VDD), IC4.6 (SHDN), IC4.10 (PR), IC4.13 (VL), IC5.7 (V+), IC6.1 (IN), L4.2, L5.1, R5.2, R8.2, R9.2, R11.2, R12.2; also elsewhere on the board
VMON1: IC2.P$5 (SENSE), IC2.P$6 (OUT), JP8.2; also elsewhere on the board
VSET1: IC1.3 (+IN), IC1.6 (-IN), R14.2; also elsewhere on the board
VSS: CP5.+, LP2.P$2 (2), U1.P$14 (14/VS)

Notes on the sheet:
Jumper to disable heating
Jumper to disable cooling
Connect to DPST switch to turn output on/off
200k -> 10 uA 20k -> 100 uA 2k -> 1 mA
VSET protection circuit - disable heating below ~0.8V
VSET protection circuit - disable cooling above ~2V
+5V filtered
+V filtered
5V input
VSS Input
Sensor+ Sensor- OutB (TEC+) OutA (TEC-)
Ask Allessandro about how/if to decouple analog/digital supplies/gnd
twisted pair to front panel
Use 2.5V IC or use AD5624R-5 DAC that has an internal 2.5V reference

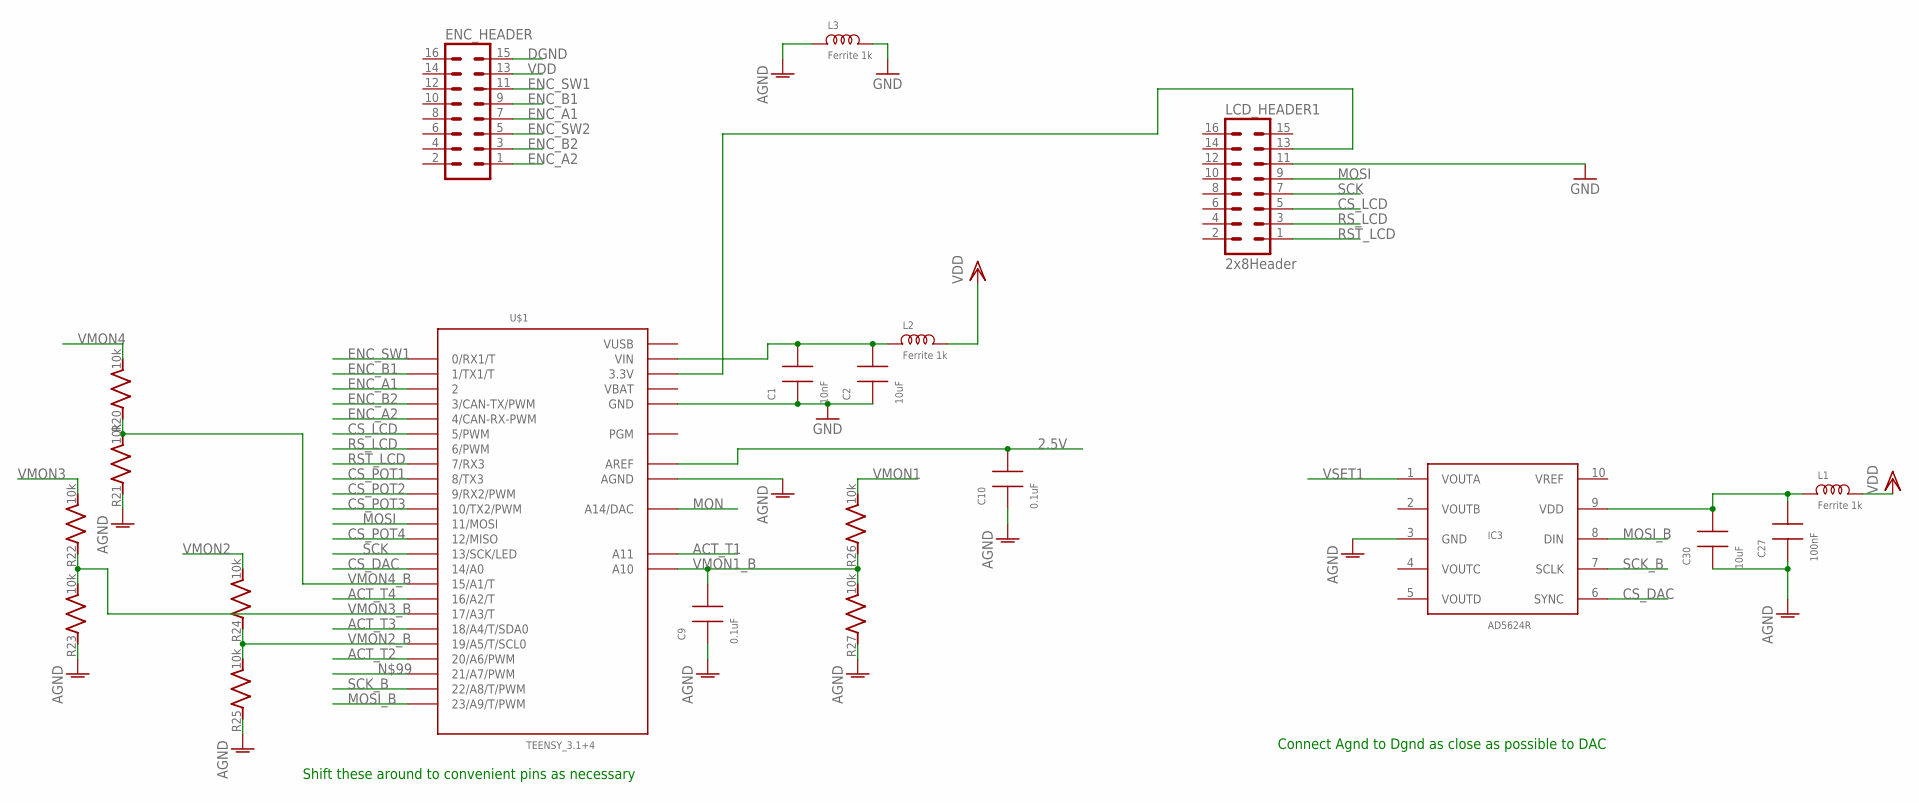
[picture p6: schematic Linear-Temperature-Controller.sch, sheet 2]

Parts:
C1: 10nF; 0805
C2, C30: 10uF; 0805
C9, C10: 0.1uF; 0805
C27: 100nF; 0805
ENC_HEADER: ML16
IC3: AD5624R; MSOP10
L1, L2, L3: Ferrite 1k; 0805
LCD_HEADER1: 2x8Header; ML16; PARTNO S9171-ND
R20, R21, R22, R23, R24, R25: 10k; R_0805
R26, R27: 10k; R_1206
U$1: TEENSY_3.1+4

Connections:
2.5V: C10.2, U$1.AREF; also elsewhere on the board
ACT_T1: U$1.A11; also elsewhere on the board
ACT_T2: U$1.20/A6 (20/A6/PWM)
ACT_T3: U$1.18/A4 (18/A4/T/SDA0)
ACT_T4: U$1.16/A2 (16/A2/T)
AGND: C9.1, C10.1, C27.1, C30.1, IC3.3 (GND), L3.1, R21.P$1 (1), R23.P$1 (1), R25.P$1 (1), R27.P$1 (1), U$1.AGND; also elsewhere on the board
CS_DAC: IC3.6 (SYNC), U$1.14/A0
CS_LCD: LCD_HEADER1.5, U$1.5 (5/PWM)
CS_POT1: U$1.8 (8/TX3); also elsewhere on the board
CS_POT2: U$1.9 (9/RX2/PWM)
CS_POT3: U$1.10 (10/TX2/PWM)
CS_POT4: U$1.12 (12/MISO)
DGND: C1.1, C2.1, ENC_HEADER.15, L3.2, LCD_HEADER1.11, U$1.GND, U$1.GND1 (GND); also elsewhere on the board
ENC_A1: ENC_HEADER.7, U$1.2
ENC_A2: ENC_HEADER.1, U$1.4 (4/CAN-RX-PWM)
ENC_B1: ENC_HEADER.9, U$1.1 (1/TX1/T)
ENC_B2: ENC_HEADER.3, U$1.3 (3/CAN-TX/PWM)
ENC_SW1: ENC_HEADER.11, U$1.0 (0/RX1/T)
ENC_SW2: ENC_HEADER.5
MON: U$1.A14 (A14/DAC); also elsewhere on the board
MOSI: LCD_HEADER1.9, U$1.11 (11/MOSI)
MOSI_B: IC3.8 (DIN), U$1.23/A9 (23/A9/T/PWM); also elsewhere on the board
unnamed: LCD_HEADER1.13, U$1.3.3V, U$1.3.3V1 (3.3V)
unnamed: C27.2, C30.2, IC3.9 (VDD), L1.1
unnamed: C1.2, C2.2, L2.1, U$1.VIN
RST_LCD: LCD_HEADER1.1, U$1.7 (7/RX3)
RS_LCD: LCD_HEADER1.3, U$1.6 (6/PWM)
SCK: LCD_HEADER1.7, U$1.13 (13/SCK/LED)
SCK_B: IC3.7 (SCLK), U$1.22/A8 (22/A8/T/PWM); also elsewhere on the board
VBAT: U$1.VBAT
VDD: ENC_HEADER.13, L1.2, L2.2; also elsewhere on the board
VMON1: R26.P$2 (2); also elsewhere on the board
VMON1_B: C9.2, R26.P$1 (1), R27.P$2 (2), U$1.A10
VMON2: R24.P$2 (2)
VMON2_B: R24.P$1 (1), R25.P$2 (2), U$1.19/A5 (19/A5/T/SCL0)
VMON3: R22.P$2 (2)
VMON3_B: R22.P$1 (1), R23.P$2 (2), U$1.17/A3 (17/A3/T)
VMON4: R20.P$2 (2)
VMON4_B: R20.P$1 (1), R21.P$2 (2), U$1.15/A1 (15/A1/T)
VSET1: IC3.1 (VOUTA); also elsewhere on the board
VUSB: U$1.VUSB

Notes on the sheet:
Shift these around to convenient pins as necessary
Connect Agnd to Dgnd as close as possible to DAC

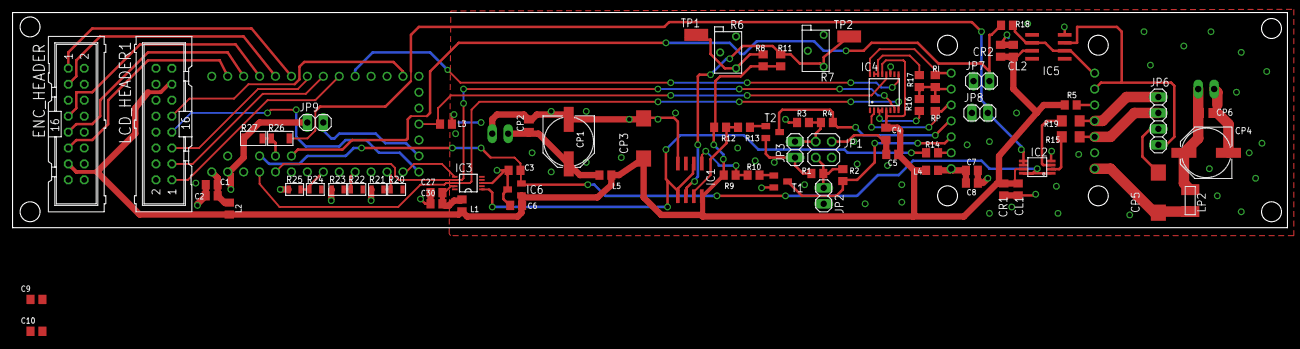
[picture p7: board Linear-Temperature-Controller.brd from above]

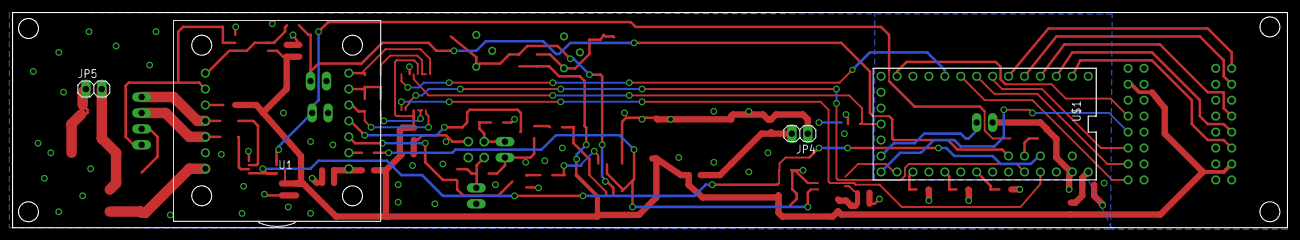
[picture p8: board Linear-Temperature-Controller.brd from below]

Board: 2 copper layers, 203.2 x 34.3 mm, 80 parts (4 on the bottom side), 56 nets.
