JQIamo/Linear-Temperature-Controller/v1_0 (first prod run)/mainBoard_v1_0/LinTempCont_4ch_V1_0.brd

## EAGLE design v1_0 (first prod run)/mainBoard_v1_0/LinTempCont_4ch_V1_0.brd (2015-10-14)

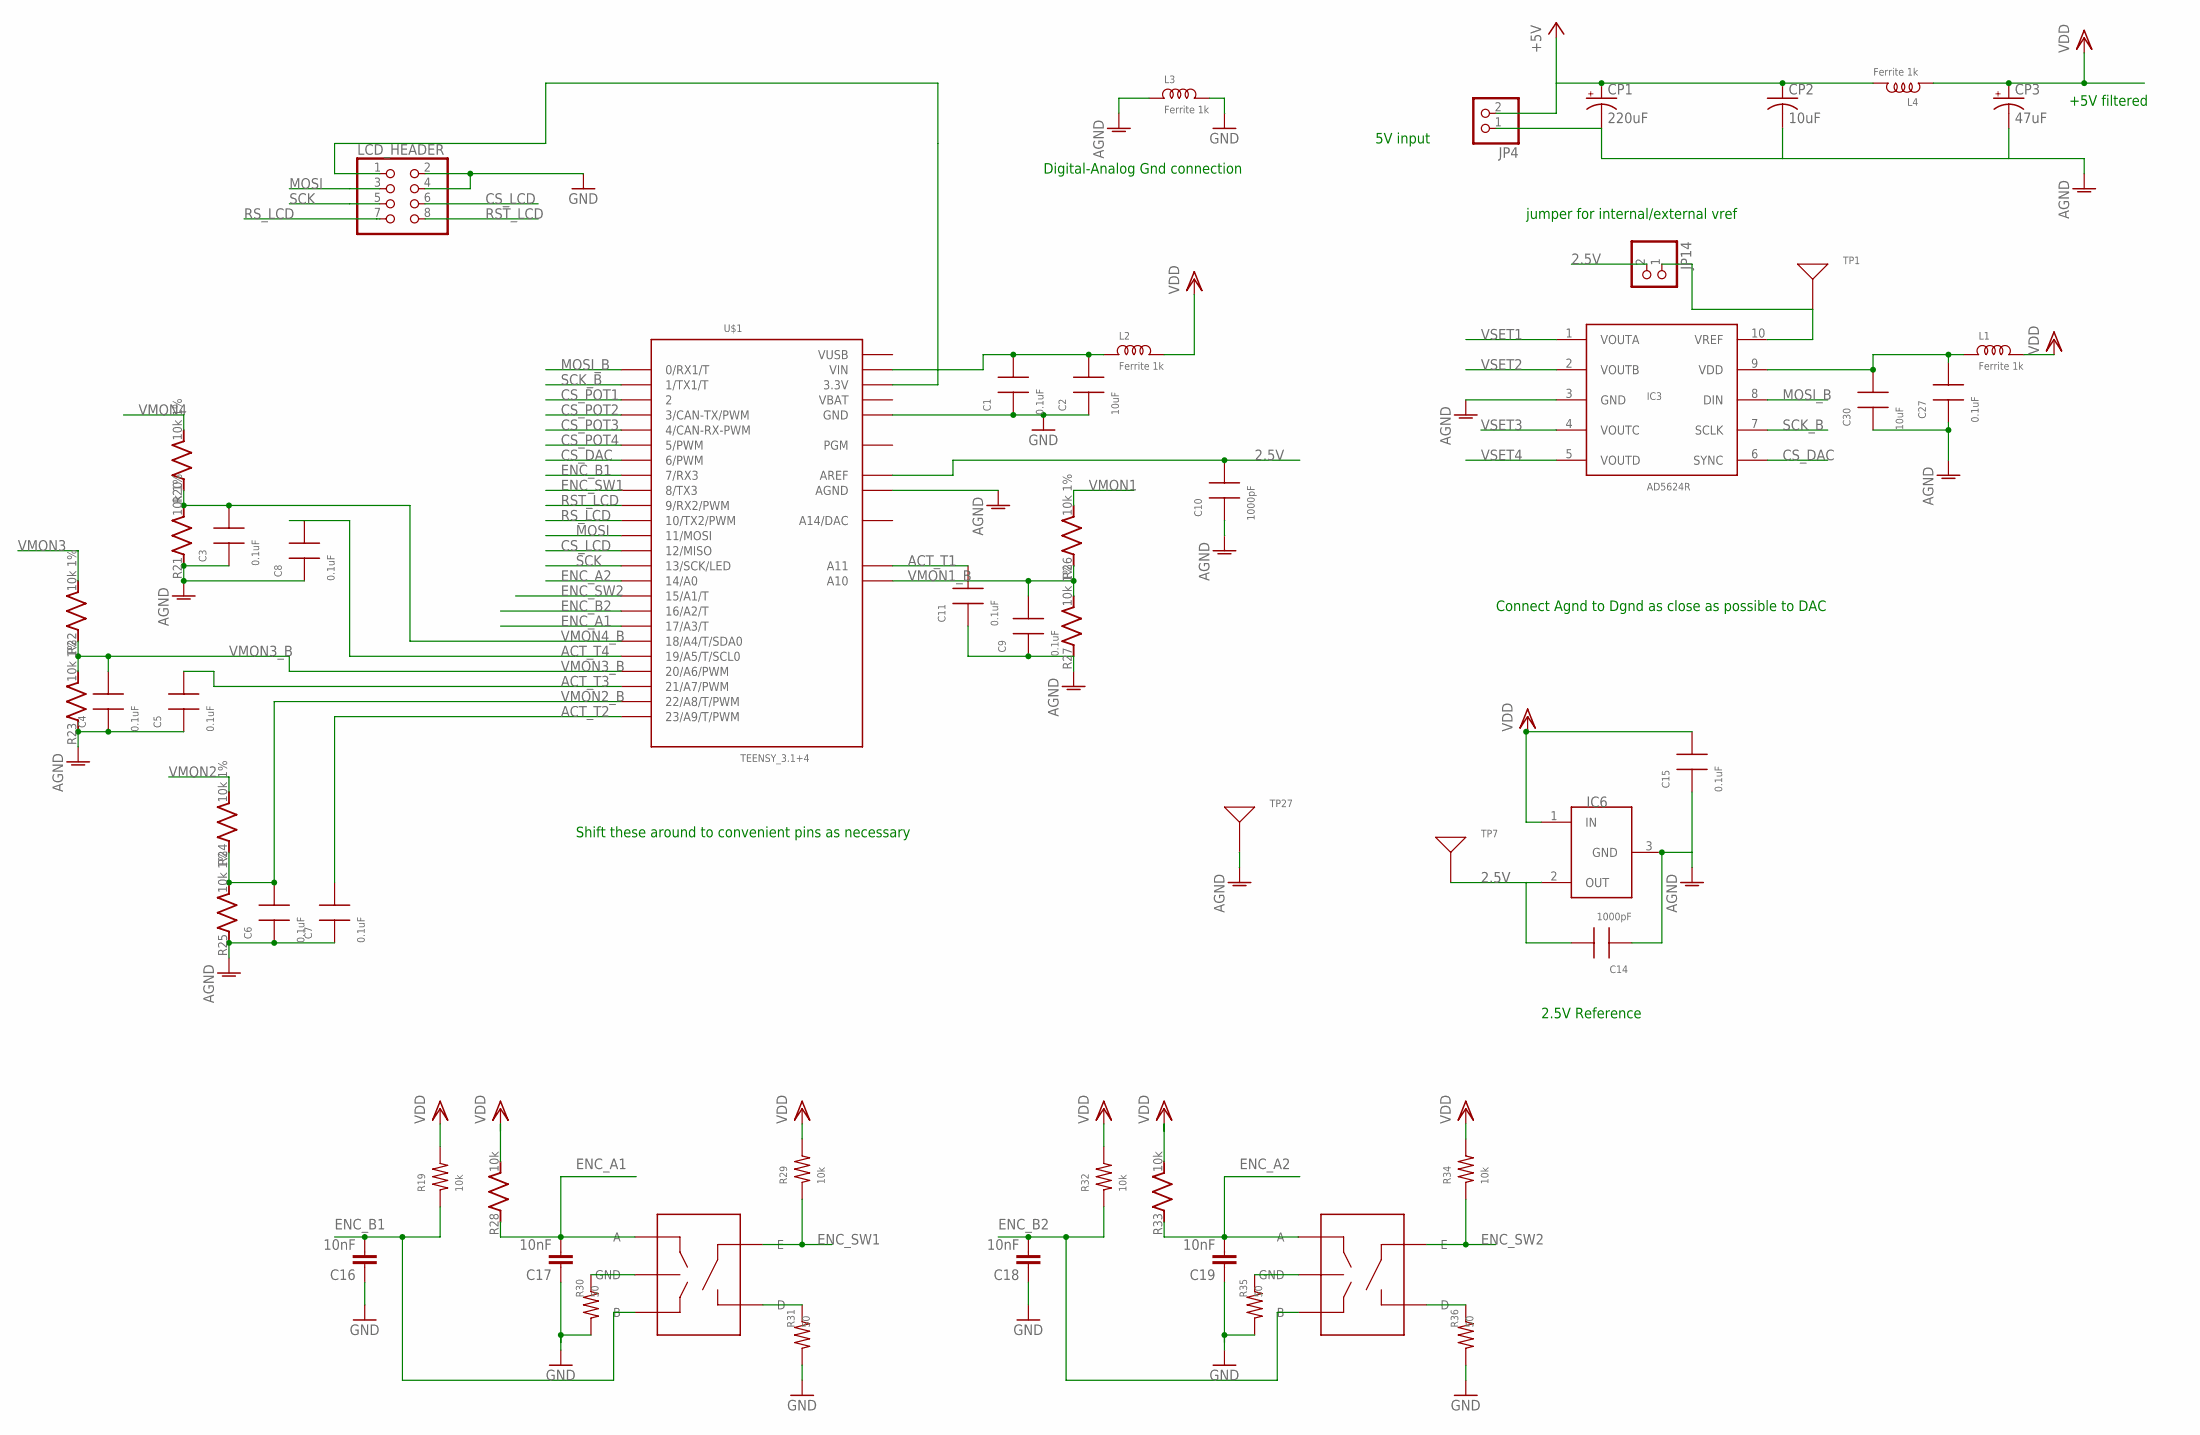
[picture p9: schematic LinTempCont_4ch_V1_0.sch, sheet 1, Digital and DAC]

Parts:
C1, C3, C4, C5, C6, C7, C8, C9, C11, C15, C27: 0.1uF; 0603
C2, C30: 10uF; 0805
C10, C14: 1000pF; 0603
C16, C17, C18, C19: 10nF; C0603
CP1: 220uF; PANASONIC_F
CP2: 10uF; C0805K
CP3: 47uF; CT7343
ENC1, ENC2: PEC09; PEC092320FS
IC3: AD5624R; MSOP10
IC6: TS6001; SOT-23
JP4: SCRWTRM-1X2; 1X02_SCRWTRM
JP14: PINHD-1X2; 1X02
L1, L2, L3, L4: Ferrite 1k; 0805
LCD_HEADER: PINHD-2X4-SHROUD; ML08
R19, R29, R32, R34: 10k; 0603
R20, R21, R22, R23, R24, R25, R26, R27: 10k 1%; R_0603
R28, R33: 10k; R_0603
R30, R31, R35, R36: 50; 0603
TP1, TP7, TP27: TESTPT; 1206TESTPAD
U$1: TEENSY_3.1+4

Connections:
2.5V: C10.2, C14.2, IC6.2 (OUT), JP14.2, TP7.P$1, U$1.AREF; also elsewhere on the board
3.3V: LCD_HEADER.1, U$1.3.3V, U$1.3.3V1 (3.3V)
+5V: CP1.+, CP2.1, JP4.2, L4.2
ACT_T1: C11.2, U$1.A11; also elsewhere on the board
ACT_T2: C7.2, U$1.23/A9 (23/A9/T/PWM); also elsewhere on the board
ACT_T3: C5.2, U$1.21/A7 (21/A7/PWM); also elsewhere on the board
ACT_T4: C8.2, U$1.19/A5 (19/A5/T/SCL0); also elsewhere on the board
AGND: C3.1, C4.1, C5.1, C6.1, C7.1, C8.1, C9.1, C10.1, C11.1, C14.1, C15.1, C27.1, C30.1, CP1.-, CP2.2, CP3.-, IC3.3 (GND), IC6.3 (GND), JP4.1, L3.1, R21.P$1 (1), R23.P$1 (1), R25.P$1 (1), R27.P$1 (1), TP27.P$1, U$1.AGND; also elsewhere on the board
CS_DAC: IC3.6 (SYNC), U$1.6 (6/PWM)
CS_LCD: LCD_HEADER.6, U$1.12 (12/MISO)
CS_POT1: U$1.2; also elsewhere on the board
CS_POT2: U$1.3 (3/CAN-TX/PWM); also elsewhere on the board
CS_POT3: U$1.4 (4/CAN-RX-PWM); also elsewhere on the board
CS_POT4: U$1.5 (5/PWM); also elsewhere on the board
DGND: C1.1, C2.1, C16.1, C17.1, C18.1, C19.1, L3.2, LCD_HEADER.2, LCD_HEADER.4, R30.1, R31.1, R35.1, R36.1, U$1.GND, U$1.GND1 (GND); also elsewhere on the board
ENC_A1: C17.2, ENC1.A, R28.P$1 (1), U$1.17/A3 (17/A3/T)
ENC_A2: C19.2, ENC2.A, R33.P$1 (1), U$1.14/A0
ENC_B1: C16.2, ENC1.B, R19.1, U$1.7 (7/RX3)
ENC_B2: C18.2, ENC2.B, R32.1, U$1.16/A2 (16/A2/T)
ENC_SW1: ENC1.E, R29.1, U$1.8 (8/TX3)
ENC_SW2: ENC2.E, R34.1, U$1.15/A1 (15/A1/T)
MOSI: LCD_HEADER.3, U$1.11 (11/MOSI)
MOSI_B: IC3.8 (DIN), U$1.0 (0/RX1/T); also elsewhere on the board
unnamed: IC3.10 (VREF), JP14.1, TP1.P$1
unnamed: ENC1.C (GND), R30.2
unnamed: ENC1.D, R31.2
unnamed: ENC2.C (GND), R35.2
unnamed: ENC2.D, R36.2
unnamed: C27.2, C30.2, IC3.9 (VDD), L1.1
unnamed: C1.2, C2.2, L2.1, U$1.VIN
RST_LCD: LCD_HEADER.8, U$1.9 (9/RX2/PWM)
RS_LCD: LCD_HEADER.7, U$1.10 (10/TX2/PWM)
SCK: LCD_HEADER.5, U$1.13 (13/SCK/LED)
SCK_B: IC3.7 (SCLK), U$1.1 (1/TX1/T); also elsewhere on the board
VBAT: U$1.VBAT
VDD: C15.2, CP3.+, IC6.1 (IN), L1.2, L2.2, L4.1, R19.2, R28.P$2 (2), R29.2, R32.2, R33.P$2 (2), R34.2; also elsewhere on the board
VMON1: R26.P$2 (2); also elsewhere on the board
VMON1_B: C9.2, R26.P$1 (1), R27.P$2 (2), U$1.A10
VMON2: R24.P$2 (2); also elsewhere on the board
VMON2_B: C6.2, R24.P$1 (1), R25.P$2 (2), U$1.22/A8 (22/A8/T/PWM)
VMON3: R22.P$2 (2); also elsewhere on the board
VMON3_B: C4.2, R22.P$1 (1), R23.P$2 (2), U$1.20/A6 (20/A6/PWM)
VMON4: R20.P$2 (2); also elsewhere on the board
VMON4_B: C3.2, R20.P$1 (1), R21.P$2 (2), U$1.18/A4 (18/A4/T/SDA0)
VSET1: IC3.1 (VOUTA); also elsewhere on the board
VSET2: IC3.2 (VOUTB); also elsewhere on the board
VSET3: IC3.4 (VOUTC); also elsewhere on the board
VSET4: IC3.5 (VOUTD); also elsewhere on the board
VUSB: U$1.VUSB

Notes on the sheet:
Shift these around to convenient pins as necessary
Digital-Analog Gnd connection
Connect Agnd to Dgnd as close as possible to DAC
2.5V Reference
+5V filtered
5V input
jumper for internal/external vref

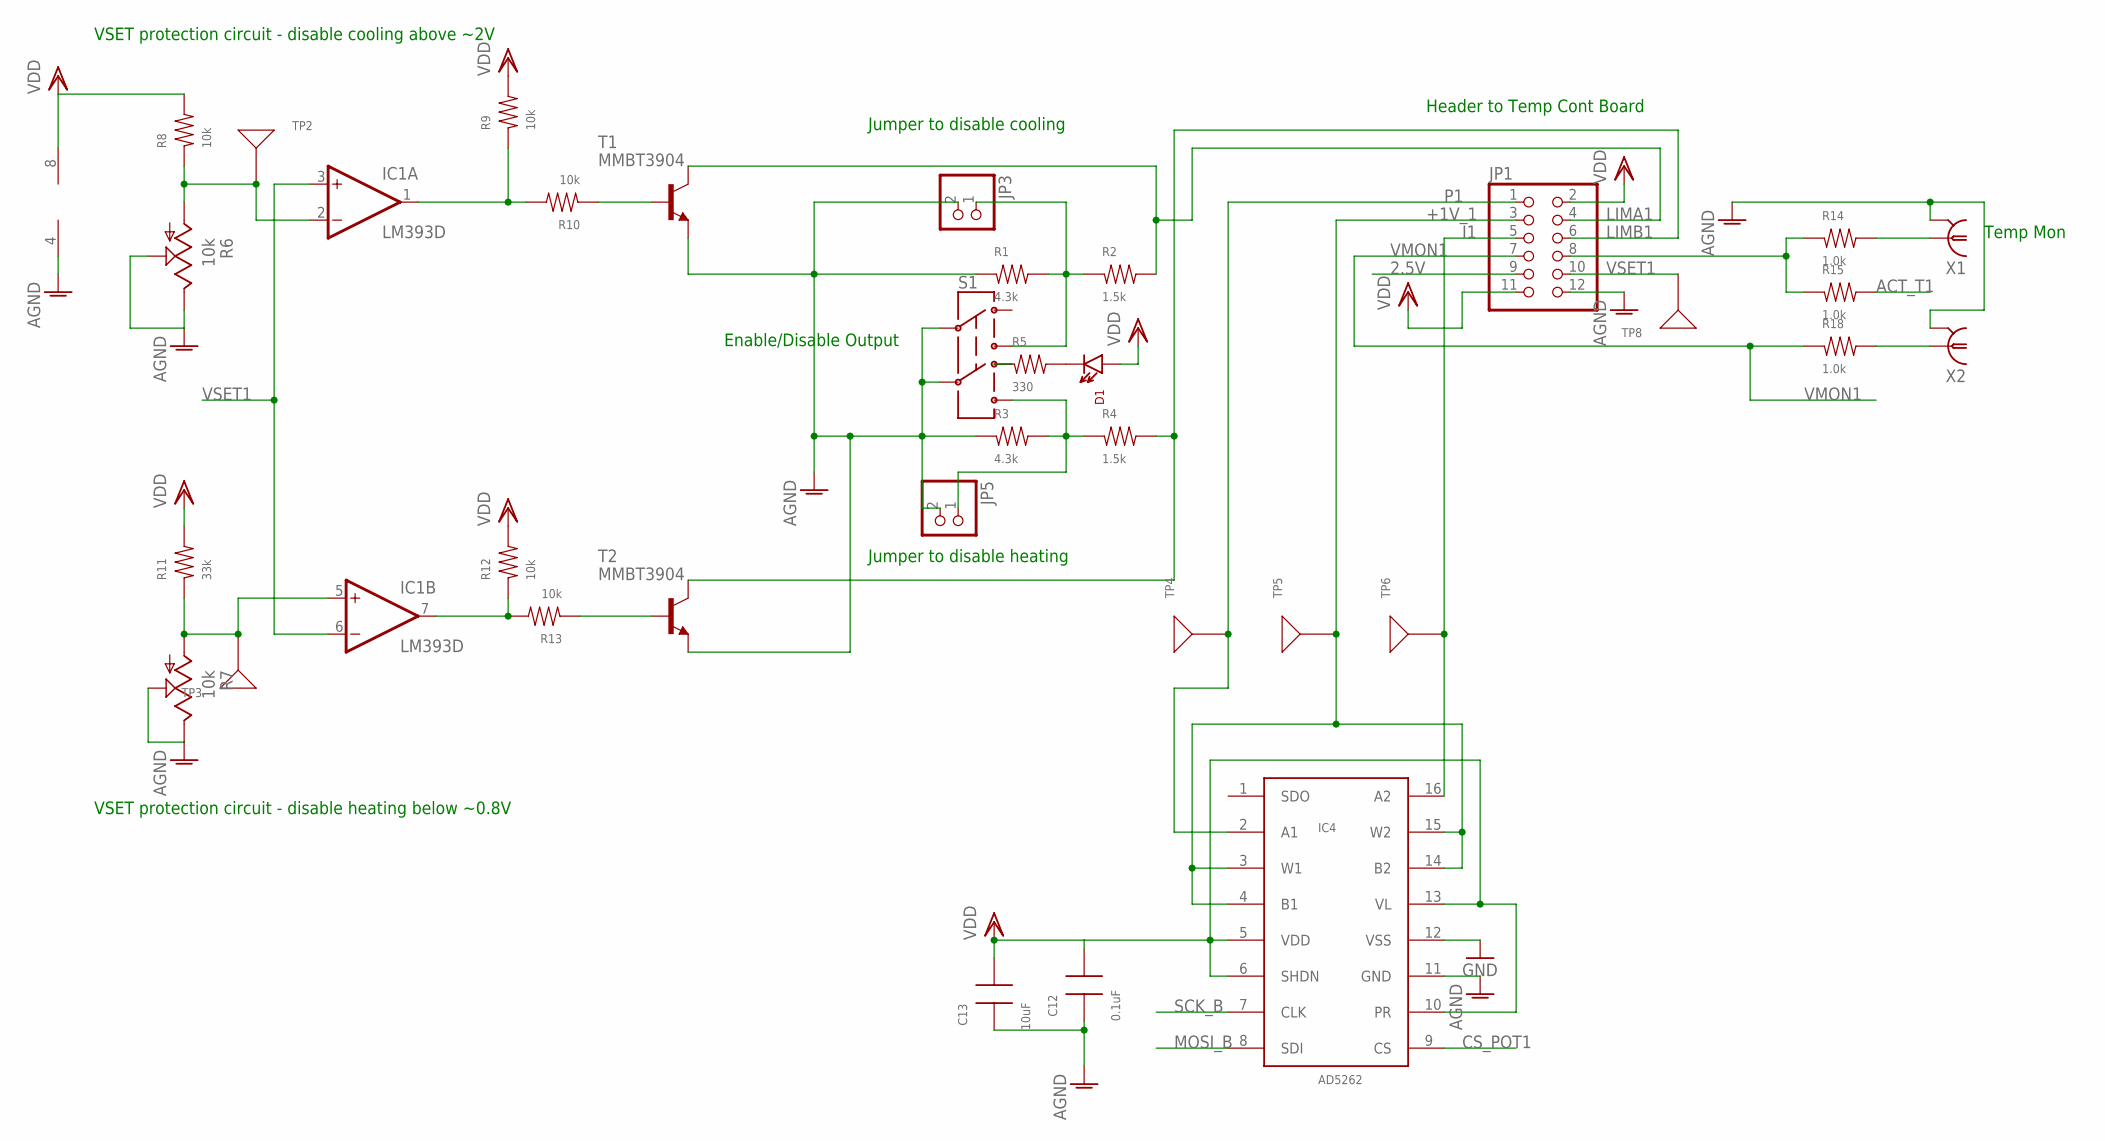
[picture p10: schematic LinTempCont_4ch_V1_0.sch, sheet 2, Ch1]

Parts:
C12: 0.1uF; 0603
C13: 10uF; 0805
D1: LED/MINI-IND; HLMP--F0010
IC1: LM393D; SO08
IC4: AD5262; TSSOP16
JP1: PINHD-2X6/90; 2X06/90
JP3, JP5: PINHD-1X2; 1X02
R1, R3: 4.3k; 0603
R2, R4: 1.5k; 0603
R5: 330; 0603
R6, R7: 10k; 64WPOT
R8, R9, R10, R12, R13: 10k; 0603
R11: 33k; 0603
R14, R15, R18: 1.0k; 0603
S1: SWITCH-DPDT/VER; E-SWITCH-100-M7
T1, T2: MMBT3904; SOT-23
TP2, TP3, TP4, TP5, TP6, TP8: TESTPT; 1206TESTPAD
X1, X2: BNC-H; BNC90

Connections:
2.5V: JP1.9; also elsewhere on the board
+1V_1: IC4.3 (W1), IC4.4 (B1), IC4.14 (B2), IC4.15 (W2), JP1.3, TP5.P$1
ACT_T1: R15.2; also elsewhere on the board
AGND: C12.1, C13.1, IC1.4 (V-), IC4.11 (GND), JP1.12, JP3.2, JP5.2, R1.1, R3.1, R6.P$2 (2), R6.P$3 (3), R7.P$2 (2), R7.P$3 (3), S1.P$2 (2), S1.P$5 (5), T1.2 (E), T2.2 (E), X1.2, X2.2; also elsewhere on the board
CS_POT1: IC4.9 (CS); also elsewhere on the board
DGND: IC4.12 (VSS); also elsewhere on the board
I1: IC4.16 (A2), JP1.5, TP6.P$1
LIMA1: JP1.4, R2.2, T1.3 (C)
LIMB1: JP1.6, R4.2, T2.3 (C)
MOSI_B: IC4.8 (SDI); also elsewhere on the board
unnamed: JP3.1, R1.2, R2.1, S1.P$3 (3)
unnamed: R14.2, X1.1
unnamed: JP5.1, R3.2, R4.1, S1.P$6 (6)
unnamed: IC1.2 (-IN), R6.P$1 (1), R8.1, TP2.P$1
unnamed: IC1.5 (+IN), R7.P$1 (1), R11.1, TP3.P$1
unnamed: IC1.7 (OUT), R12.1, R13.2
unnamed: IC1.1 (OUT), R9.1, R10.2
unnamed: R10.1, T1.1 (B)
unnamed: R13.1, T2.1 (B)
unnamed: D1.C, R5.2
unnamed: R5.1, S1.P$4 (4)
unnamed: R18.2, X2.1
unnamed: JP1.8, R14.1, R15.1
P1: IC4.2 (A1), JP1.1, TP4.P$1
SCK_B: IC4.7 (CLK); also elsewhere on the board
VDD: C12.2, C13.2, D1.A, IC1.8 (V+), IC4.5 (VDD), IC4.6 (SHDN), IC4.10 (PR), IC4.13 (VL), JP1.2, JP1.11, R8.2, R9.2, R11.2, R12.2; also elsewhere on the board
VMON1: JP1.7, R18.1; also elsewhere on the board
VSET1: IC1.3 (+IN), IC1.6 (-IN), JP1.10, TP8.P$1; also elsewhere on the board

Notes on the sheet:
Header to Temp Cont Board
Jumper to disable heating
Jumper to disable cooling
Enable/Disable Output
VSET protection circuit - disable heating below ~0.8V
VSET protection circuit - disable cooling above ~2V
Temp Mon
