JQIamo/Linear-Temperature-Controller/v1_0 (first prod run)/mainBoard_v1_0/LinTempCont_4ch_V1_0.brd

## EAGLE design v1_0 (first prod run)/mainBoard_v1_0/LinTempCont_4ch_V1_0.brd (continued)

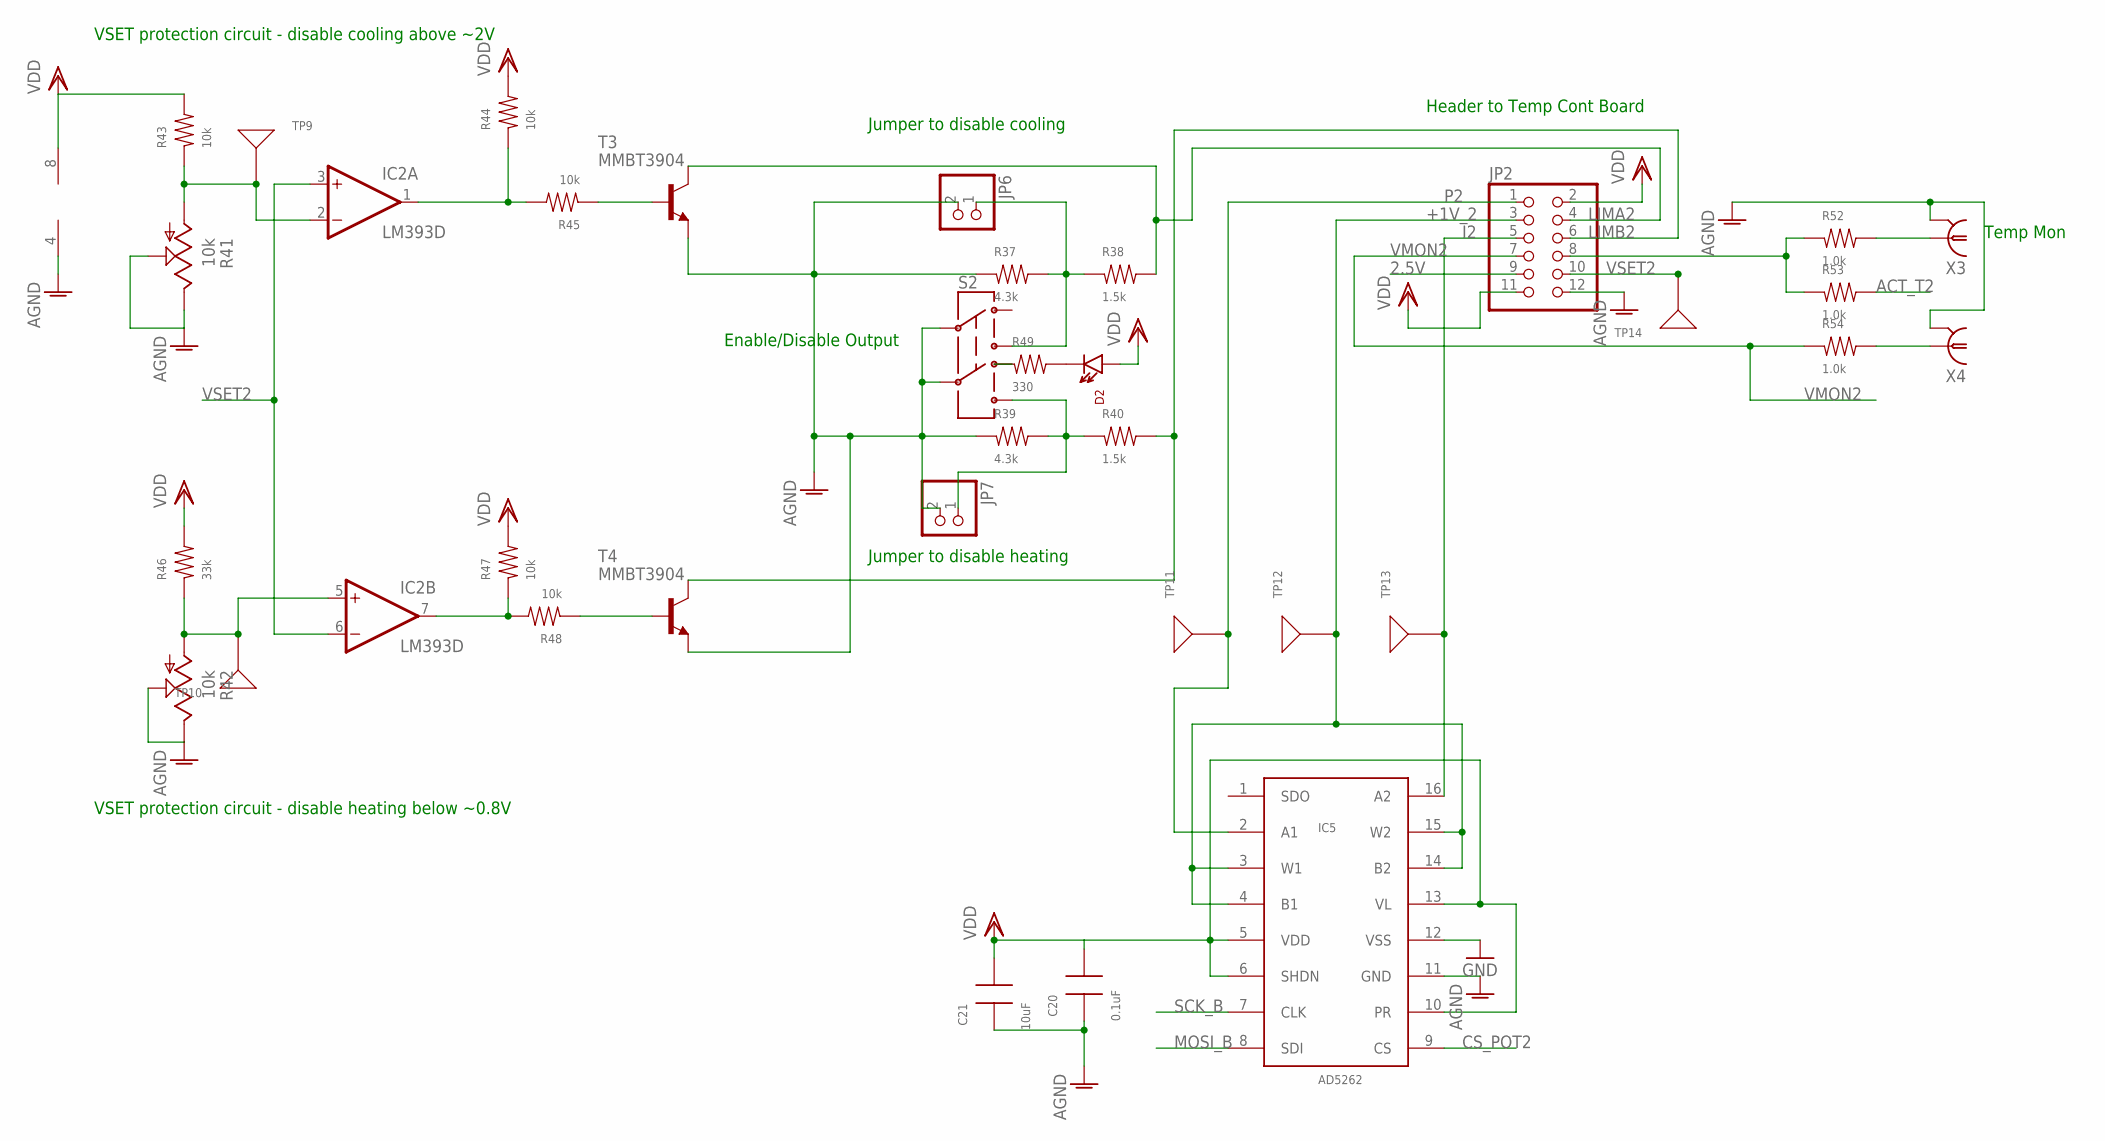
[picture p11: schematic LinTempCont_4ch_V1_0.sch, sheet 3, Ch2]

Parts:
C20: 0.1uF; 0603
C21: 10uF; 0805
D2: LED/MINI-IND; HLMP--F0010
IC2: LM393D; SO08
IC5: AD5262; TSSOP16
JP2: PINHD-2X6/90; 2X06/90
JP6, JP7: PINHD-1X2; 1X02
R37, R39: 4.3k; 0603
R38, R40: 1.5k; 0603
R41, R42: 10k; 64WPOT
R43, R44, R45, R47, R48: 10k; 0603
R46: 33k; 0603
R49: 330; 0603
R52, R53, R54: 1.0k; 0603
S2: SWITCH-DPDT/VER; E-SWITCH-100-M7
T3, T4: MMBT3904; SOT-23
TP9, TP10, TP11, TP12, TP13, TP14: TESTPT; 1206TESTPAD
X3, X4: BNC-H; BNC90

Connections:
2.5V: JP2.9; also elsewhere on the board
+1V_2: IC5.3 (W1), IC5.4 (B1), IC5.14 (B2), IC5.15 (W2), JP2.3, TP12.P$1
ACT_T2: R53.2; also elsewhere on the board
AGND: C20.1, C21.1, IC2.4 (V-), IC5.11 (GND), JP2.12, JP6.2, JP7.2, R37.1, R39.1, R41.P$2 (2), R41.P$3 (3), R42.P$2 (2), R42.P$3 (3), S2.P$2 (2), S2.P$5 (5), T3.2 (E), T4.2 (E), X3.2, X4.2; also elsewhere on the board
CS_POT2: IC5.9 (CS); also elsewhere on the board
DGND: IC5.12 (VSS); also elsewhere on the board
I2: IC5.16 (A2), JP2.5, TP13.P$1
LIMA2: JP2.4, R38.2, T3.3 (C)
LIMB2: JP2.6, R40.2, T4.3 (C)
MOSI_B: IC5.8 (SDI); also elsewhere on the board
unnamed: JP6.1, R37.2, R38.1, S2.P$3 (3)
unnamed: JP7.1, R39.2, R40.1, S2.P$6 (6)
unnamed: IC2.2 (-IN), R41.P$1 (1), R43.1, TP9.P$1
unnamed: IC2.1 (OUT), R44.1, R45.2
unnamed: R45.1, T3.1 (B)
unnamed: IC2.5 (+IN), R42.P$1 (1), R46.1, TP10.P$1
unnamed: IC2.7 (OUT), R47.1, R48.2
unnamed: R48.1, T4.1 (B)
unnamed: D2.C, R49.2
unnamed: R49.1, S2.P$4 (4)
unnamed: JP2.8, R52.1, R53.1
unnamed: R52.2, X3.1
unnamed: R54.2, X4.1
P2: IC5.2 (A1), JP2.1, TP11.P$1
SCK_B: IC5.7 (CLK); also elsewhere on the board
VDD: C20.2, C21.2, D2.A, IC2.8 (V+), IC5.5 (VDD), IC5.6 (SHDN), IC5.10 (PR), IC5.13 (VL), JP2.2, JP2.11, R43.2, R44.2, R46.2, R47.2; also elsewhere on the board
VMON2: JP2.7, R54.1; also elsewhere on the board
VSET2: IC2.3 (+IN), IC2.6 (-IN), JP2.10, TP14.P$1; also elsewhere on the board

Notes on the sheet:
Header to Temp Cont Board
Jumper to disable heating
Jumper to disable cooling
Enable/Disable Output
VSET protection circuit - disable heating below ~0.8V
VSET protection circuit - disable cooling above ~2V
Temp Mon

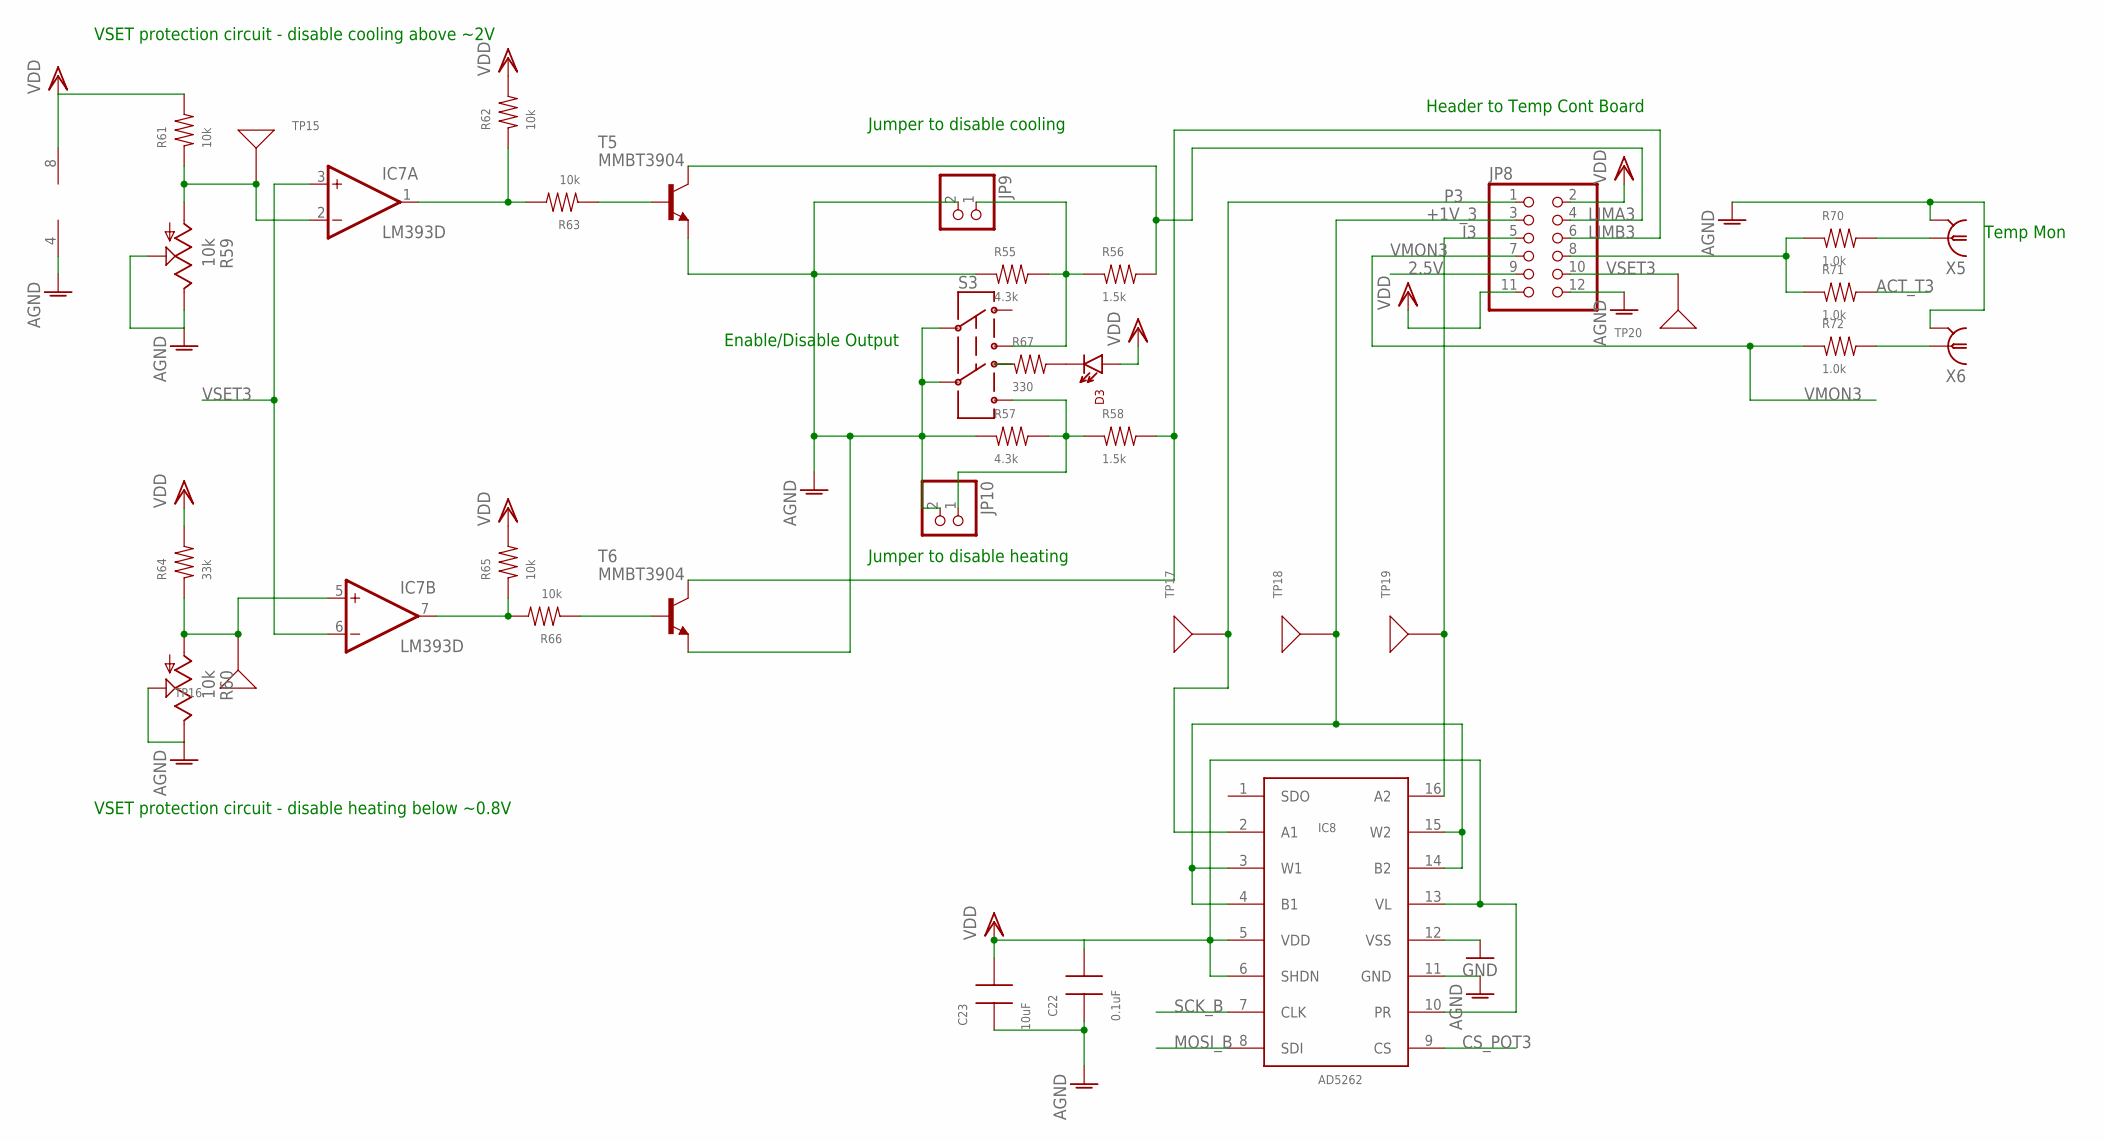
[picture p12: schematic LinTempCont_4ch_V1_0.sch, sheet 4, Ch3]

Parts:
C22: 0.1uF; 0603
C23: 10uF; 0805
D3: LED/MINI-IND; HLMP--F0010
IC7: LM393D; SO08
IC8: AD5262; TSSOP16
JP8: PINHD-2X6/90; 2X06/90
JP9, JP10: PINHD-1X2; 1X02
R55, R57: 4.3k; 0603
R56, R58: 1.5k; 0603
R59, R60: 10k; 64WPOT
R61, R62, R63, R65, R66: 10k; 0603
R64: 33k; 0603
R67: 330; 0603
R70, R71, R72: 1.0k; 0603
S3: SWITCH-DPDT/VER; E-SWITCH-100-M7
T5, T6: MMBT3904; SOT-23
TP15, TP16, TP17, TP18, TP19, TP20: TESTPT; 1206TESTPAD
X5, X6: BNC-H; BNC90

Connections:
2.5V: JP8.9; also elsewhere on the board
+1V_3: IC8.3 (W1), IC8.4 (B1), IC8.14 (B2), IC8.15 (W2), JP8.3, TP18.P$1
ACT_T3: R71.2; also elsewhere on the board
AGND: C22.1, C23.1, IC7.4 (V-), IC8.11 (GND), JP8.12, JP9.2, JP10.2, R55.1, R57.1, R59.P$2 (2), R59.P$3 (3), R60.P$2 (2), R60.P$3 (3), S3.P$2 (2), S3.P$5 (5), T5.2 (E), T6.2 (E), X5.2, X6.2; also elsewhere on the board
CS_POT3: IC8.9 (CS); also elsewhere on the board
DGND: IC8.12 (VSS); also elsewhere on the board
I3: IC8.16 (A2), JP8.5, TP19.P$1
LIMA3: JP8.4, R56.2, T5.3 (C)
LIMB3: JP8.6, R58.2, T6.3 (C)
MOSI_B: IC8.8 (SDI); also elsewhere on the board
unnamed: JP9.1, R55.2, R56.1, S3.P$3 (3)
unnamed: JP10.1, R57.2, R58.1, S3.P$6 (6)
unnamed: IC7.2 (-IN), R59.P$1 (1), R61.1, TP15.P$1
unnamed: IC7.1 (OUT), R62.1, R63.2
unnamed: R63.1, T5.1 (B)
unnamed: IC7.5 (+IN), R60.P$1 (1), R64.1, TP16.P$1
unnamed: IC7.7 (OUT), R65.1, R66.2
unnamed: R66.1, T6.1 (B)
unnamed: D3.C, R67.2
unnamed: R67.1, S3.P$4 (4)
unnamed: JP8.8, R70.1, R71.1
unnamed: R70.2, X5.1
unnamed: R72.2, X6.1
P3: IC8.2 (A1), JP8.1, TP17.P$1
SCK_B: IC8.7 (CLK); also elsewhere on the board
VDD: C22.2, C23.2, D3.A, IC7.8 (V+), IC8.5 (VDD), IC8.6 (SHDN), IC8.10 (PR), IC8.13 (VL), JP8.2, JP8.11, R61.2, R62.2, R64.2, R65.2; also elsewhere on the board
VMON3: JP8.7, R72.1; also elsewhere on the board
VSET3: IC7.3 (+IN), IC7.6 (-IN), JP8.10, TP20.P$1; also elsewhere on the board

Notes on the sheet:
Header to Temp Cont Board
Jumper to disable heating
Jumper to disable cooling
Enable/Disable Output
VSET protection circuit - disable heating below ~0.8V
VSET protection circuit - disable cooling above ~2V
Temp Mon

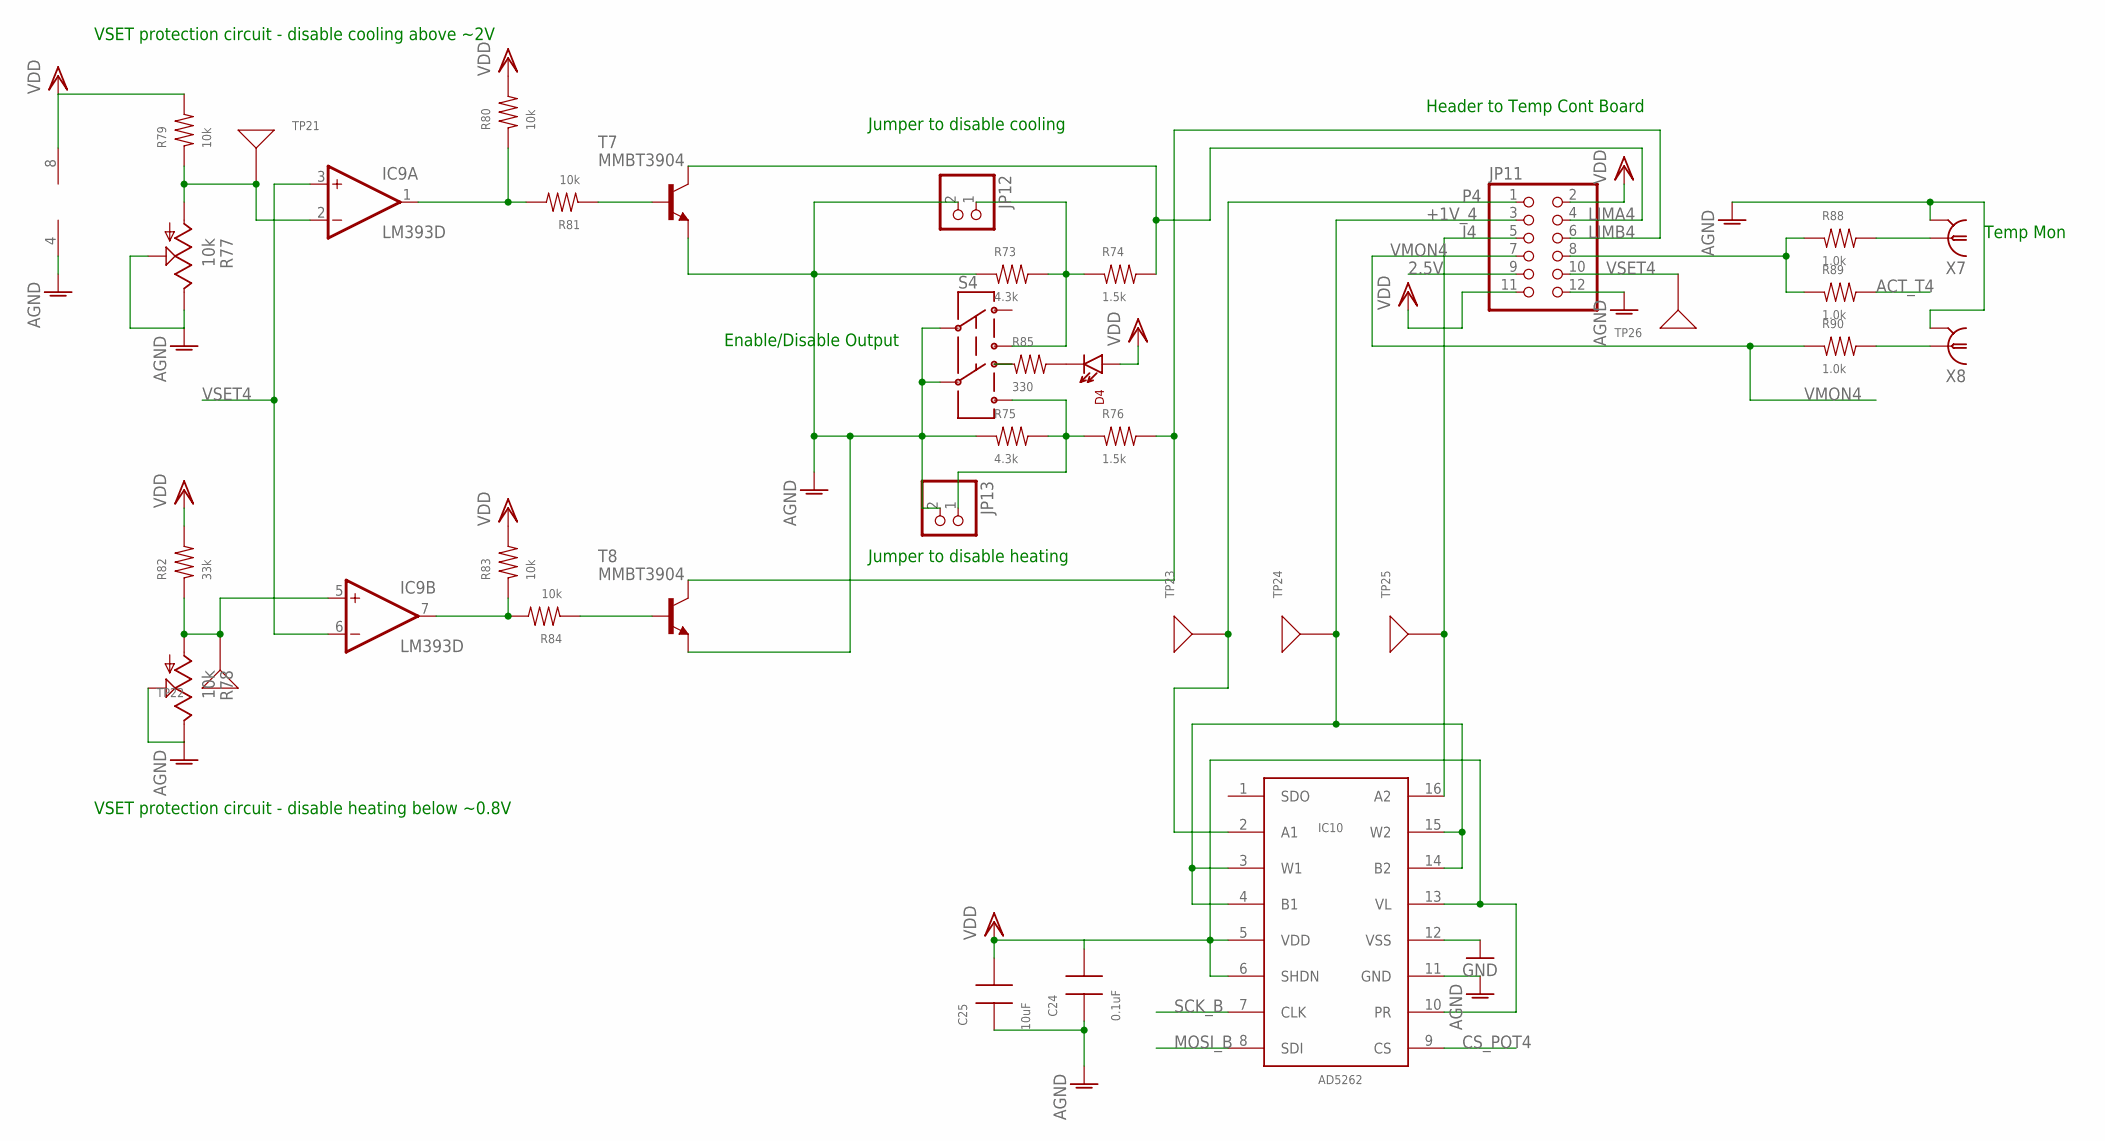
[picture p13: schematic LinTempCont_4ch_V1_0.sch, sheet 5, Ch4]

Parts:
C24: 0.1uF; 0603
C25: 10uF; 0805
D4: LED/MINI-IND; HLMP--F0010
IC9: LM393D; SO08
IC10: AD5262; TSSOP16
JP11: PINHD-2X6/90; 2X06/90
JP12, JP13: PINHD-1X2; 1X02
R73, R75: 4.3k; 0603
R74, R76: 1.5k; 0603
R77, R78: 10k; 64WPOT
R79, R80, R81, R83, R84: 10k; 0603
R82: 33k; 0603
R85: 330; 0603
R88, R89, R90: 1.0k; 0603
S4: SWITCH-DPDT/VER; E-SWITCH-100-M7
T7, T8: MMBT3904; SOT-23
TP21, TP22, TP23, TP24, TP25, TP26: TESTPT; 1206TESTPAD
X7, X8: BNC-H; BNC90

Connections:
2.5V: JP11.9; also elsewhere on the board
+1V_4: IC10.3 (W1), IC10.4 (B1), IC10.14 (B2), IC10.15 (W2), JP11.3, TP24.P$1
ACT_T4: R89.2; also elsewhere on the board
AGND: C24.1, C25.1, IC9.4 (V-), IC10.11 (GND), JP11.12, JP12.2, JP13.2, R73.1, R75.1, R77.P$2 (2), R77.P$3 (3), R78.P$2 (2), R78.P$3 (3), S4.P$2 (2), S4.P$5 (5), T7.2 (E), T8.2 (E), X7.2, X8.2; also elsewhere on the board
CS_POT4: IC10.9 (CS); also elsewhere on the board
DGND: IC10.12 (VSS); also elsewhere on the board
I4: IC10.16 (A2), JP11.5, TP25.P$1
LIMA4: JP11.4, R74.2, T7.3 (C)
LIMB4: JP11.6, R76.2, T8.3 (C)
MOSI_B: IC10.8 (SDI); also elsewhere on the board
unnamed: JP12.1, R73.2, R74.1, S4.P$3 (3)
unnamed: JP13.1, R75.2, R76.1, S4.P$6 (6)
unnamed: IC9.2 (-IN), R77.P$1 (1), R79.1, TP21.P$1
unnamed: IC9.1 (OUT), R80.1, R81.2
unnamed: R81.1, T7.1 (B)
unnamed: IC9.5 (+IN), R78.P$1 (1), R82.1, TP22.P$1
unnamed: IC9.7 (OUT), R83.1, R84.2
unnamed: R84.1, T8.1 (B)
unnamed: D4.C, R85.2
unnamed: R85.1, S4.P$4 (4)
unnamed: JP11.8, R88.1, R89.1
unnamed: R88.2, X7.1
unnamed: R90.2, X8.1
P4: IC10.2 (A1), JP11.1, TP23.P$1
SCK_B: IC10.7 (CLK); also elsewhere on the board
VDD: C24.2, C25.2, D4.A, IC9.8 (V+), IC10.5 (VDD), IC10.6 (SHDN), IC10.10 (PR), IC10.13 (VL), JP11.2, JP11.11, R79.2, R80.2, R82.2, R83.2; also elsewhere on the board
VMON4: JP11.7, R90.1; also elsewhere on the board
VSET4: IC9.3 (+IN), IC9.6 (-IN), JP11.10, TP26.P$1; also elsewhere on the board

Notes on the sheet:
Header to Temp Cont Board
Jumper to disable heating
Jumper to disable cooling
Enable/Disable Output
VSET protection circuit - disable heating below ~0.8V
VSET protection circuit - disable cooling above ~2V
Temp Mon

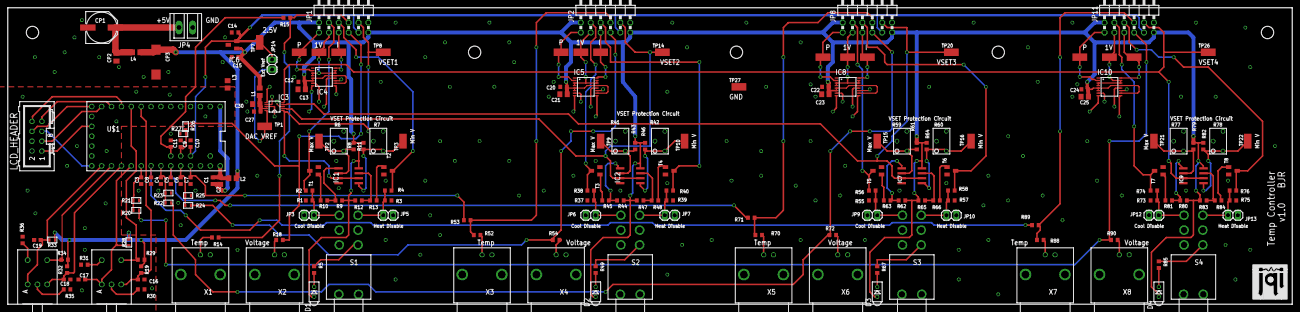
[picture p14: board LinTempCont_4ch_V1_0.brd from above]

Board: 4 copper layers, 330.2 x 76.2 mm, 196 parts (0 on the bottom side), 119 nets.

Other parts of the board:
U$2: JQI_LOGO_NEGATIVE-SILKSCREEN
