JQIamo/Linear-Temperature-Controller/(commit log)

2015-05-14 Started Eagle Schematic
    [Linear-Temperature-Controller.sch]
2015-05-15 Added current limit portion
    [Linear-Temperature-Controller.sch]
2015-05-18 Add input voltage protection
    [Linear-Temperature-Controller.sch]
2015-05-19 Schematic Progress
    Include microcontroller, DAC, digital POT and more
    [Linear-Temperature-Controller.sch]
2015-05-20 Replace microcontroller with Teensy
    [Linear-Temperature-Controller.sch]
2015-05-21 Add differential amplifier, separate AGND from DGND
    [Linear-Temperature-Controller.sch]
2015-05-25 Schematic progress
    Add 2.5V ref, swap trimpot package, add monitor headers
    [Linear-Temperature-Controller.sch]
2015-05-26 Start laying out board and update schematic
    [Linear-Temperature-Controller.brd, Linear-Temperature-Controller.sch]
2015-05-26 Progress...
    Added voltage divider to Teensy analog inputs, added a couple extra
    teensy channels, layout progress
    [Linear-Temperature-Controller.brd, Linear-Temperature-Controller.sch]
2015-05-26 Add BOM
2015-05-28 Update BOM, continue laying out board
    Also add a new board file to play around with having a bus of traces for
    eventually extending the circuit to 4 channels
    [Linear-Temperature-Controller-bus-layout.brd, Linear-Temperature-Controller-bus-layout.sch]
2015-05-28 Finished first attempt at board layout
    [Linear-Temperature-Controller-bus-layout.brd, Linear-Temperature-Controller-bus-layout.sch, Linear-Temperature-Controller.brd]
2015-06-01 Clearance increased and added few vias
    [Linear-Temperature-Controller.brd]
2015-06-09 Start arduino code
    Add header to define Teensy pins. Started writing functions to write to
    the digipot and DAC. These should eventually be moved to their own
    library.
2015-06-10 Added additional libraries
    Copied over Encoder, LCD, Menu libraries from Neal A's AOM driver
    project, added AD5262 library
2015-06-11 AD5262 library fixes, added analog read functions
    [AD5262.cpp, AD5262.h, LinTempController.ino]
2015-06-12 Incorporate and modify LCD, Encoder, Menu classes
    Copied updated LCD, Encoder, and Menu classes from Neal Anderson's AOM
    driver software. Started modifying them for my purposes, including bug
    fixes and having the encoder value tracked as a double instead of
    integer.
    [Encoder.cpp, Encoder.h, LCD.cpp, LCD.h, LinTempController.ino, Menu.cpp, Menu.h]
2015-06-22 Create WTC3243 Library
    Add a WTC3243 class to handle functions like setTemp, readTemp,
    setPropGain, setIntTimeConstant. Also added a header file to store
    settings common to the entire board.
2015-06-23 Added a few more details for encoder implementation
2015-06-23 Version 0.1
    First fully working sketch. This version incorporates four menu modes
    (set temp, set prop gain, set int time constant, monitor voltage).
    Things that still need to get added besides the obvious real world
    testing:
    -Read/Write settings to EEPROM
    -Possibly control upper/lower temp limit on front panel
    -Voltage monitor calibration
    -Add ability to have arduino analog out channel go to front panel for a
    monitor
    -Extend to multiple channels
2015-06-28 Add read/write to EEPROM
    Temp Set Pt, Pgain, Itc are now saved to memory when the encoder button
    is held. (It is easy to change this to save every hour instead). This
    commit needs testing.
2015-06-29 Fix minor errors on prototype schematic
    [Linear-Temperature-Controller.brd, Linear-Temperature-Controller.sch]
2015-06-30 Finish implementing save settings, minor code fixes
    [AD5262.cpp, AD5262.h, LinTempController.ino, Teensy_TempController.h, WTC3243.cpp]
2015-07-01 Start 4-Ch prototype schematic
    Add teensy, DAC, voltage ref, and 1 channel. Still to do: copy/paste for
    3 other channels, add rotary encoders.
    [LinTempCont_4ch_proto.sch]
2015-07-03 Main board progress, started individual channel boards
    [LinTempCont_4ch_proto.brd, LinTempCont_4ch_proto.sch, LinTempCont_indCh_proto.brd, LinTempCont_indCh_proto.sch]
2015-07-07 Schematic updates and progress routing both boards
    [LinTempCont_4ch_proto.brd, LinTempCont_4ch_proto.sch, LinTempCont_indCh_proto.brd, LinTempCont_indCh_proto.sch]
2015-07-08 Finished routing board
    Still to do: review layout, add vias, clean up silkscreen
    [LinTempCont_4ch_proto.brd]
2015-07-09 Board/Schematic updates and tweaks
    Incorporate suggestions from Neal and Alessandro
    [LinTempCont_4ch_proto.brd, LinTempCont_4ch_proto.sch, LinTempCont_indCh_proto.brd, LinTempCont_indCh_proto.sch]
2015-07-10 Board/Schematic Clean up-lcd.init tweak
    Added encoder hold event to initialize LCD to try to get around bug
    where LCD display goes blank. The bug appears to be from a loose solder
    connection on first prototype
    [LinTempCont_4ch_proto.brd, LinTempCont_4ch_proto.sch, LinTempCont_indCh_proto.brd, LinTempCont_indCh_proto.sch]
2015-07-13 Add DAC Vref Jumper/Silkscreen Cleanup
    [LinTempCont_4ch_proto.brd, LinTempCont_4ch_proto.sch, LinTempCont_indCh_proto.brd]
2015-07-15 Add BOM, minor updates to reflect part availability
    [LinTempCont_4ch_proto.brd, LinTempCont_4ch_proto.sch, LinTempCont_indCh_proto.brd, LinTempCont_indCh_proto.sch]
2015-07-15 Prepare for ordering boards
    Update BOM, minor changes to board to move header slightly, ensure
    silkscreen is using vector fonts
    [LinTempCont_4ch_proto.brd, LinTempCont_4ch_proto.sch, LinTempCont_indCh_proto.brd]
2015-07-17 Generate Gerber Files, clean up folders
    [Digikey Order.xlsx, LinTempCont_4ch_proto.brd, LinTempCont_4ch_proto.sch, LinTempCont_indCh_proto.brd, Linear-Temperature-Controller-bus-layout.brd, Linear-Temperature-Controller-bus-layout.sch, Linear-Temperature-Controller.brd, Linear-Temperature-Controller.sch]
2015-07-31 Add ability to measure max/min digipot resistances
    Untested!
2015-08-05 Start eagle files for ind. ch. V1.0 boards
    Swapped values of C4 and C5 so that the 10 uF capacitor has the 0805
    footprint and the 10 nF cap has the 0603 footprint
    [LinTempCont_indCh_V1_0.brd, LinTempCont_indCh_V1_0.sch]
2015-08-27 Update pin mappings for new board
2015-08-27 Small fix to correctly print version num to serial
    [LinTempController.ino]
2015-08-27 Modify LCD.cpp
    Add lines to ensure chip select line is set as an output pin. This
    should only be necessary when the DIN (MISO) line (pin 12 for the
    teensy) is used a the chip select. Also changed how the settings are
    initialized to allow the communication speed to be changed.
2015-09-03 Modify AD56X4R library: voltage offset & vref flag
    Add a calibration constant to include a small voltage offset in the DAC
    transfer function. Also include a flag to indicate if the DAC's voltage
    reference is external or internal
2015-09-03 Calibrate settings for 4-ch prototype
    Also add voltage offset and DAC vref flag
2015-09-03 Fix calibration menu, update encoder button_pressed()
    [Encoder.cpp, LinTempController.ino]
2015-09-03 Fixed a couple small errors found on prototype
    R1/R2, R37/R38, R73/R74 had the locations of their silkscreen labels
    swapped. Also changed value of C10 from 0.1uF to 1nF to avoid
    oscillations of voltage reference
    [LinTempCont_4ch_V1_0.brd, LinTempCont_4ch_V1_0.sch]
2015-09-03 Started version 1.1
    Replaced 2 pin jumper to switch between internal/external DAC VREF with
    a 4 pin jumper to allow placement of a 100 nF capacitor between DAC Vref
    and gnd (when internally referenced)
    [LinTempCont_4ch_V1_1.brd, LinTempCont_4ch_V1_1.sch]
2015-09-03 Minor change to trace thickness
    [LinTempCont_4ch_V1_1.brd]
2015-09-09 Add simple sketch for temp monitoring
    Uses a second teensy to log the temperature out of the control loop. Use
    a program like coolterm to monitor the values read and printed to the
    serial command line.
2015-10-14 Finish version 1
    Reorganize file structure. Package version 1 files nicely along with BOM
    in order to get boards assembled
    [Digikey Order.xlsx, LinTempCont_4ch_V1_0.brd, LinTempCont_4ch_V1_0.sch, LinTempCont_4ch_V1_1.brd, LinTempCont_4ch_V1_1.sch, LinTempCont_4ch_proto.brd, LinTempCont_4ch_proto.sch, LinTempCont_indCH_v1_0_BOM.xlsx]
2015-10-15 Add centroid files for assembly
    [LinTempCont_4ch_V1_0_centroid.csv, indCh_v0_9_centroid.csv]
2016-01-06 Add separate .h files for each version of the board (which require different calibrations)
2016-01-08 Update AD56X4R library to take an array of offset voltages (one per each of the four channels)
2016-01-15 Calibration updates
2016-08-22 Update version 2 calibration file
    dac_offset should now be an array of floats instead of a single float
2016-08-22 Add ability to print temperatures to serial line for monitoring
2016-08-22 Change format of serial port monitoring
    Replace two spaces with a tab
    [LinTempController.ino]
2016-09-09 Include EEPROMex Library in arduino folder
    If the EEPROMex library is run in debug mode, then you are limited to
    100 writes to memory, which causes problems by not saving your settings.
    This commit includes the EEPROMex files in the arduino folder so a new
    user doesn't have to remember to comment out the "define
    _EEPROMEX_DEBUG" statement in EEPROMex.cpp.
    Also, comment out the lines that print changes to the DAC setpoint to
    the serial line.
    [AD56X4R.cpp, EEPROMVar.h, LinTempController.ino]
